lgbeno/BLDC-Booster/README.md

BLDC-Booster
============

BLDC Motor Control written for MSP430 Value Line processors
