lgbeno/BLDC-Booster/DOC/Scope Trace/adc_sampling-uart.pdf

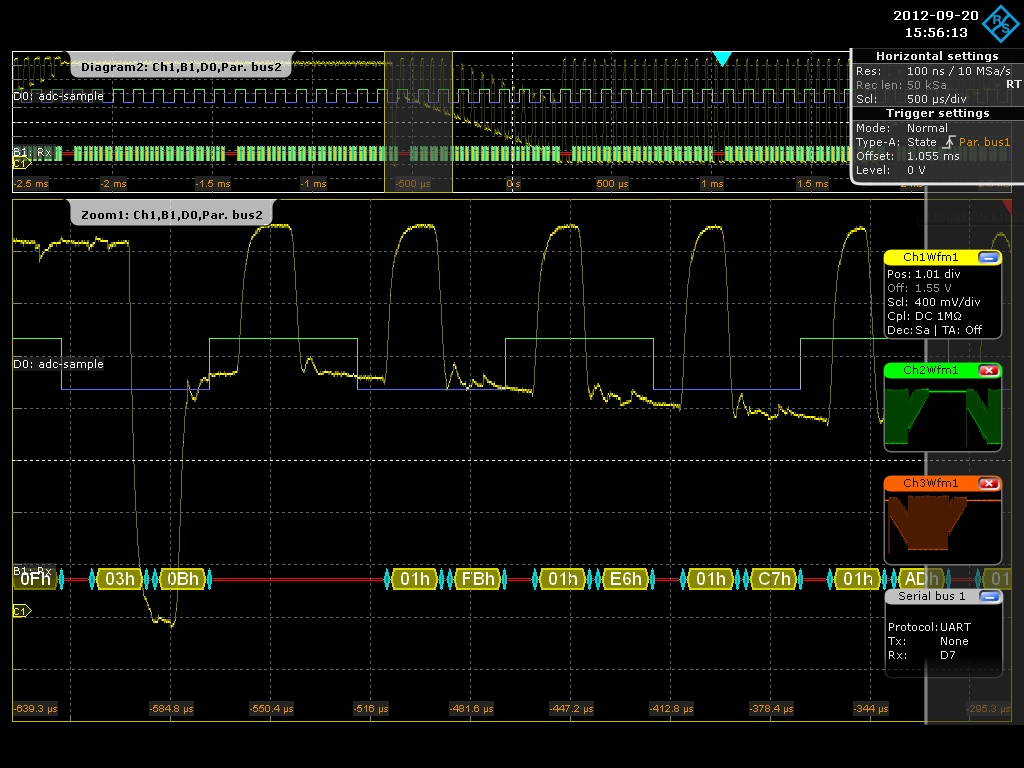
[picture p1: page 1]
