lgbeno/BLDC-Booster/DOC/Scope Trace/commutate-integral-2.pdf

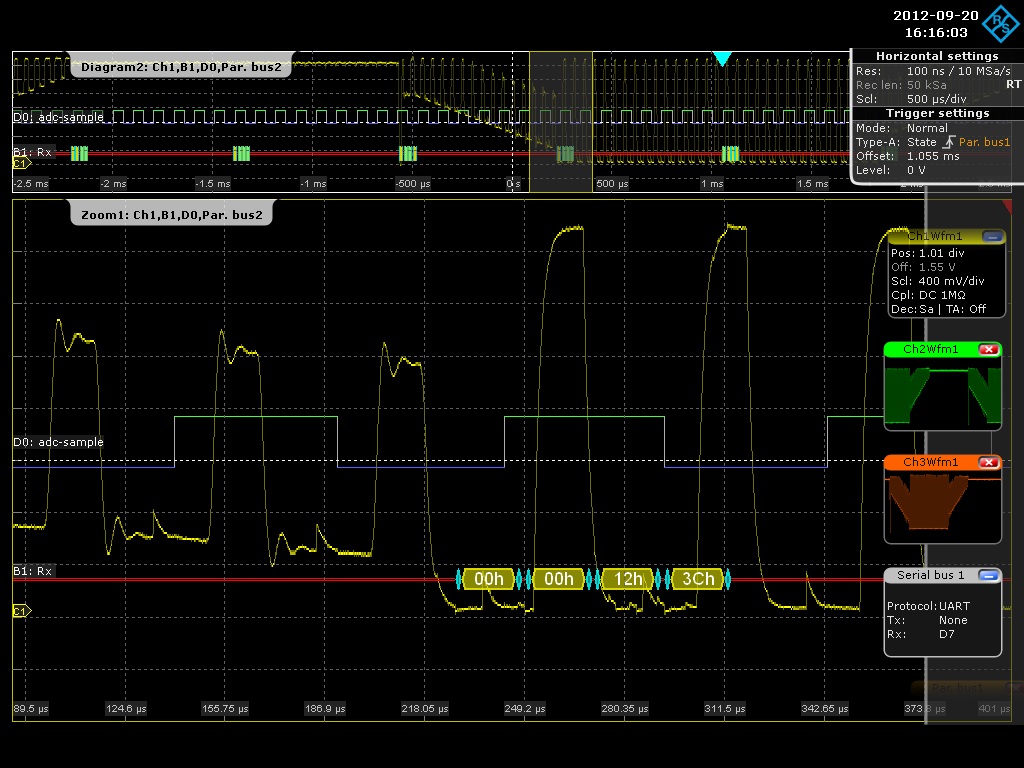
[picture p2: page 1]
