lgbeno/BLDC-Booster/DOC/Scope Trace/commutate-integral.pdf

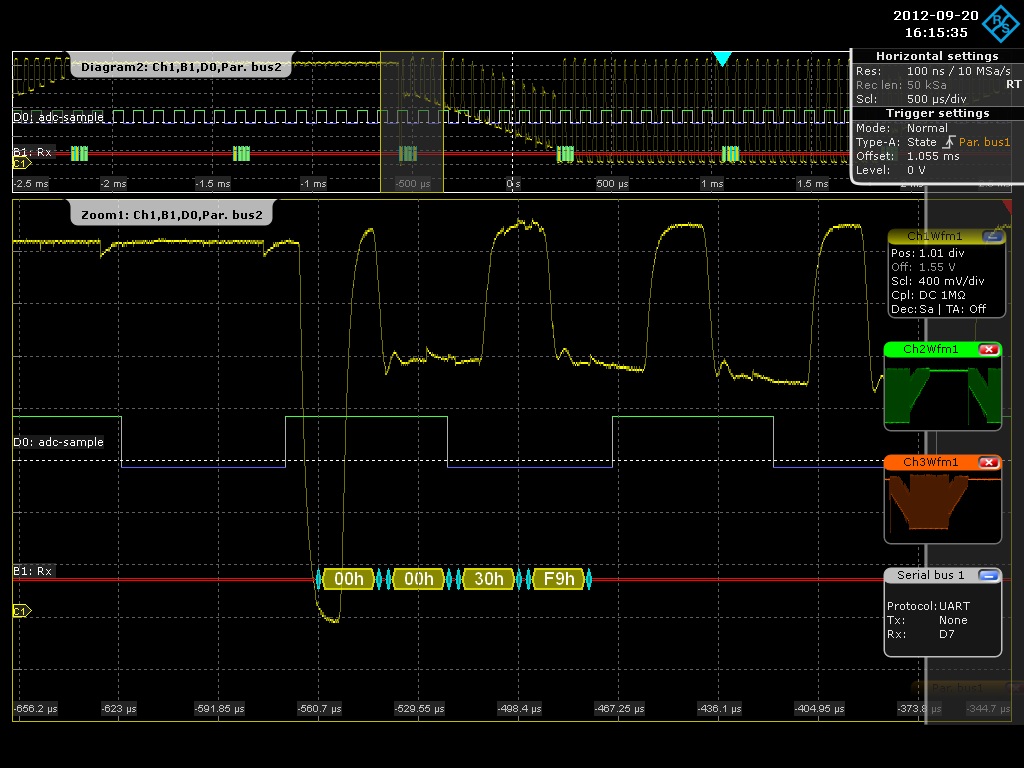
[picture p3: page 1]
