lgbeno/BLDC-Booster/DOC/Scope Trace/fullview.pdf

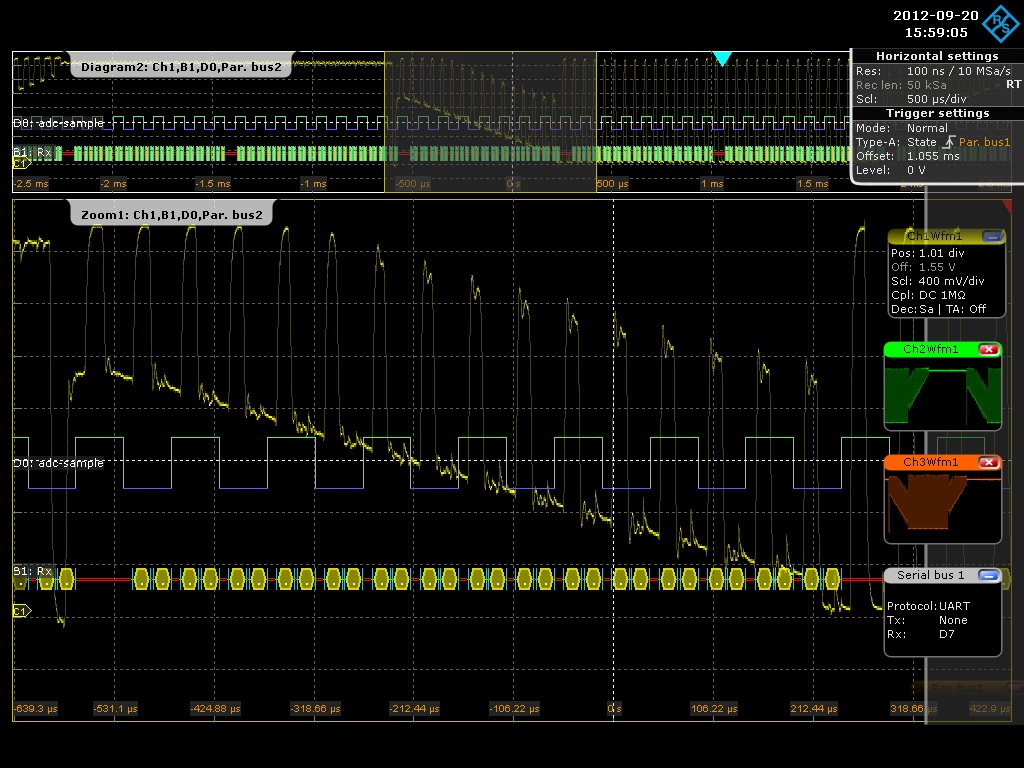
[picture p4: page 1]
