lgbeno/BLDC-Booster/DOC/Scope Trace/more-samples.pdf

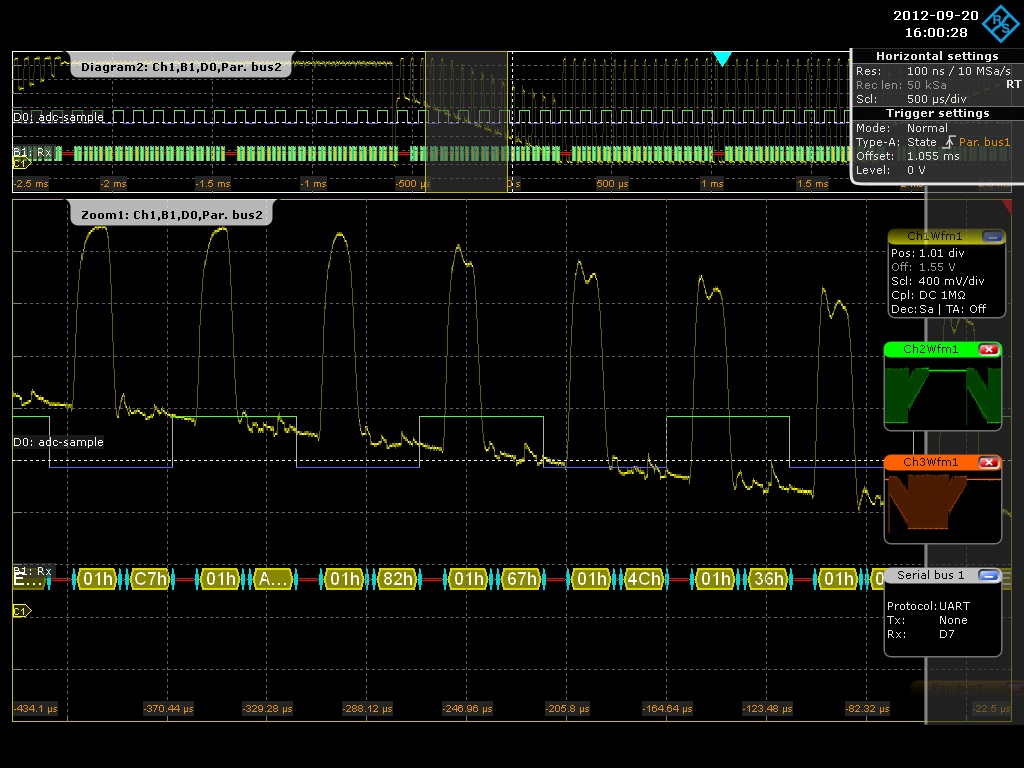
[picture p5: page 1]
