lgbeno/BLDC-Booster/DOC/integral.png

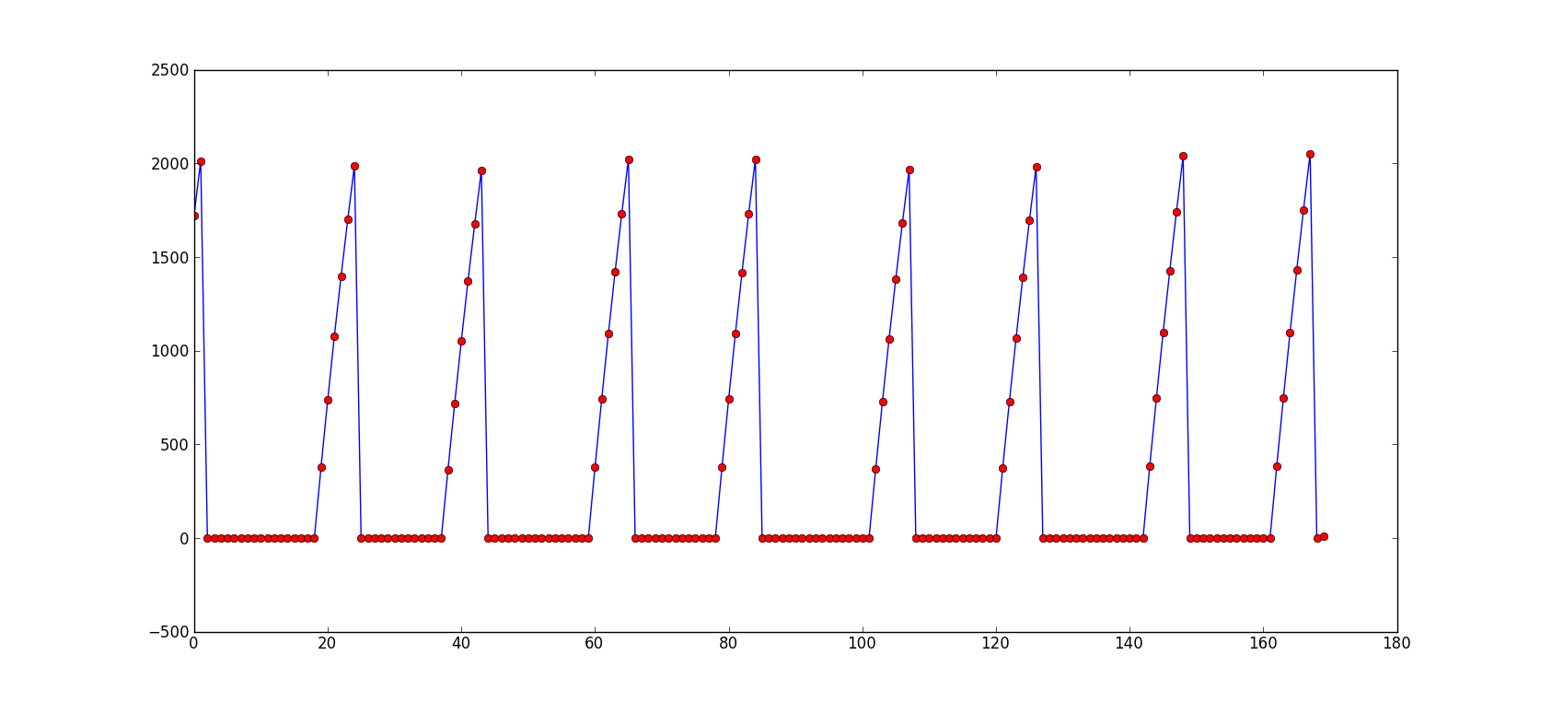
DOC/integral.png
