lgbeno/BLDC-Booster/DOC/muxed+vpwr.png

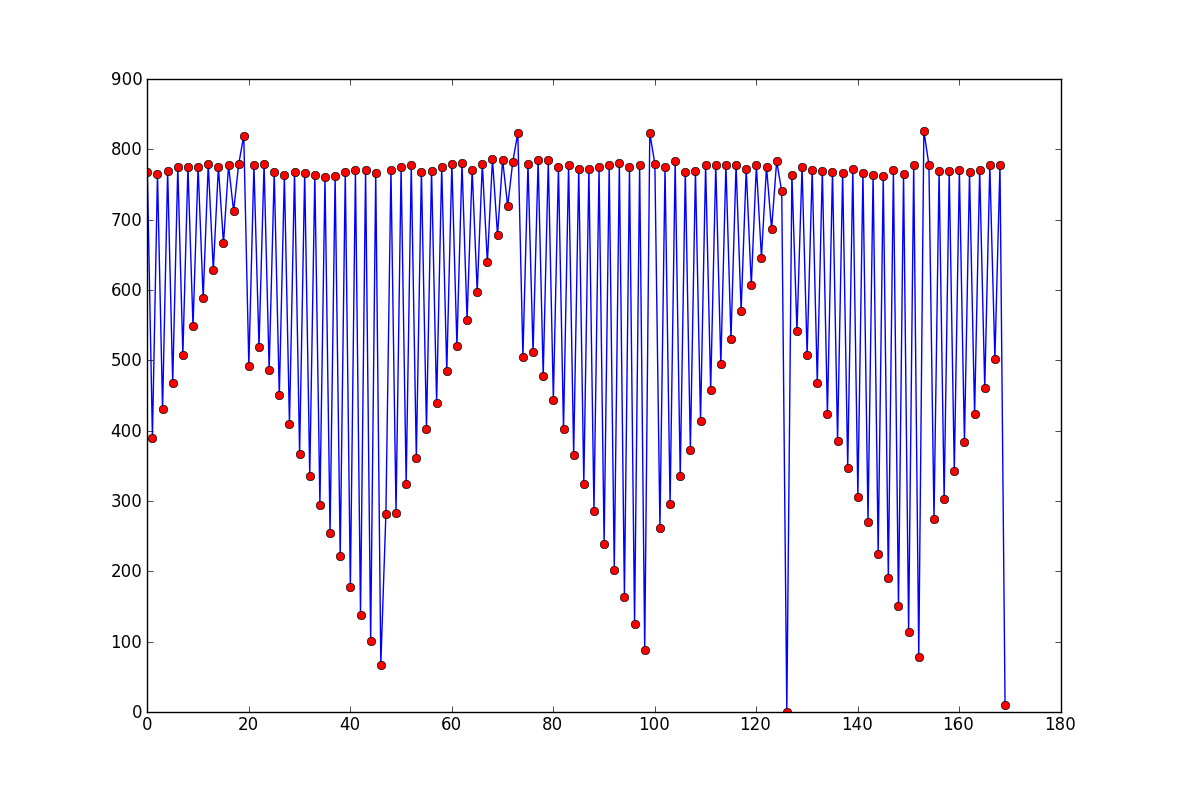
DOC/muxed+vpwr.png
