lgbeno/BLDC-Booster/DOC/Scope Trace/mtr-v2.png

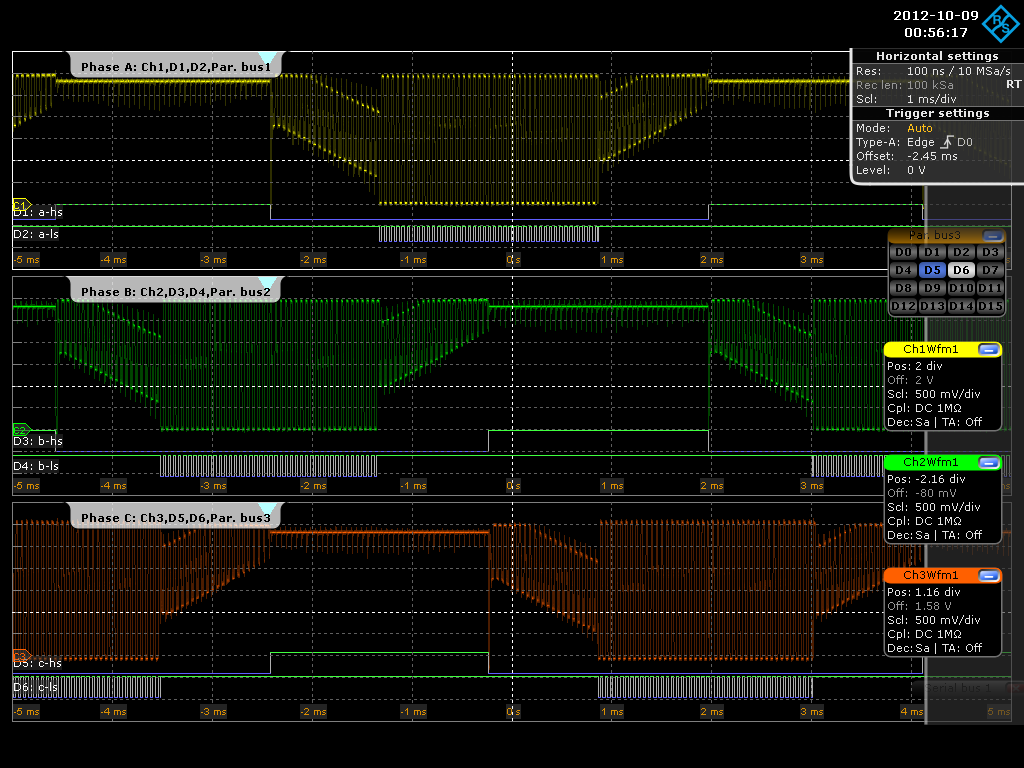
DOC/Scope Trace/mtr-v2.png
