lgbeno/BLDC-Booster/DOC/Scope Trace/mtr-v.png

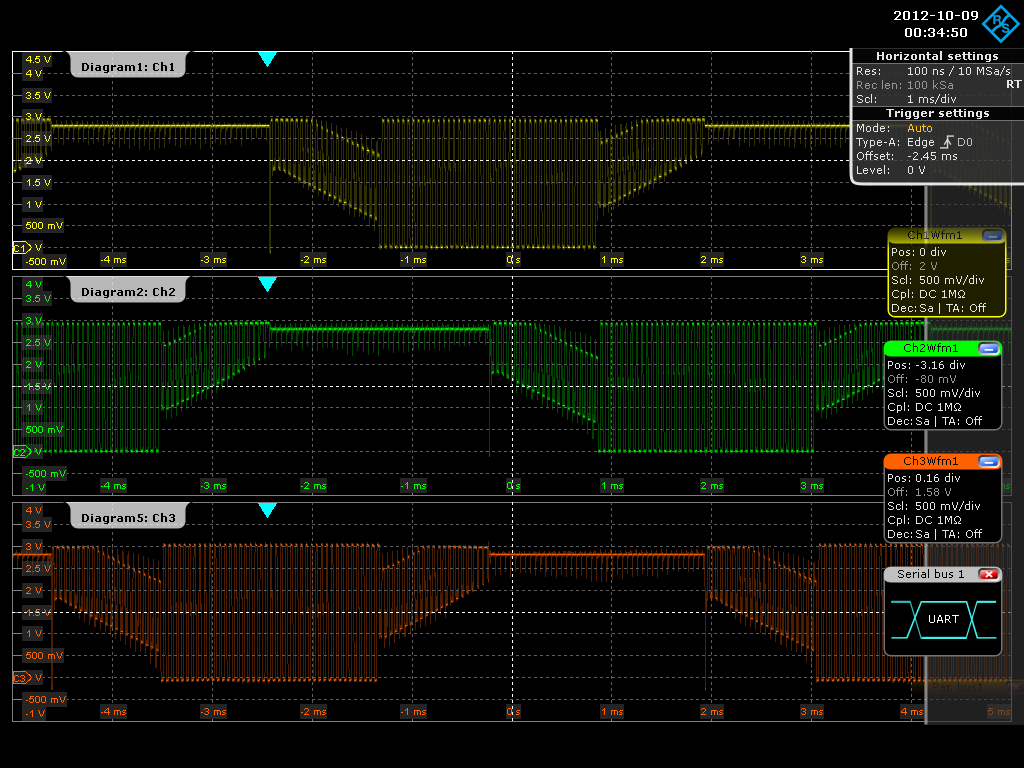
DOC/Scope Trace/mtr-v.png
