lgbeno/BLDC-Booster/DOC/single_phase+vpwr.png

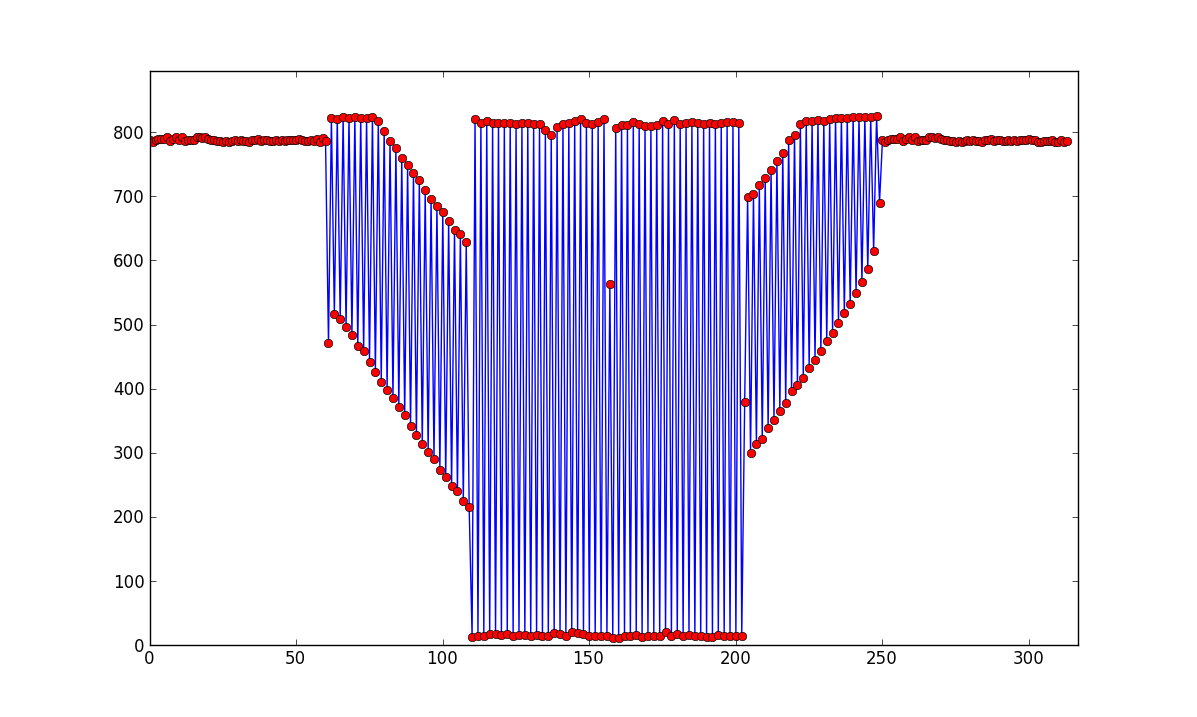
DOC/single_phase+vpwr.png
