lgbeno/BLDC-Booster/python/datasets/blanking-data/benf.png

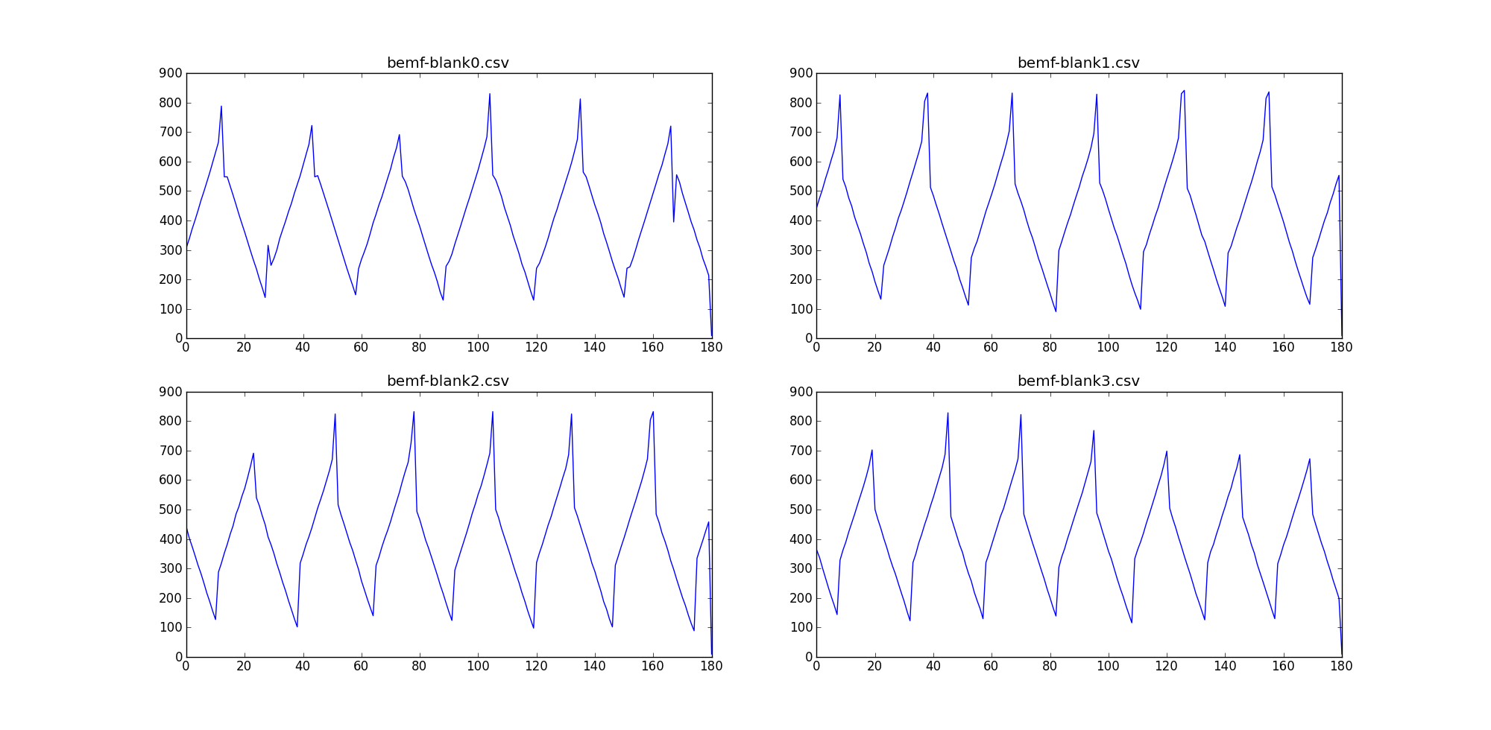
python/datasets/blanking-data/benf.png
