lgbeno/BLDC-Booster/python/datasets/blanking-data/integral.png

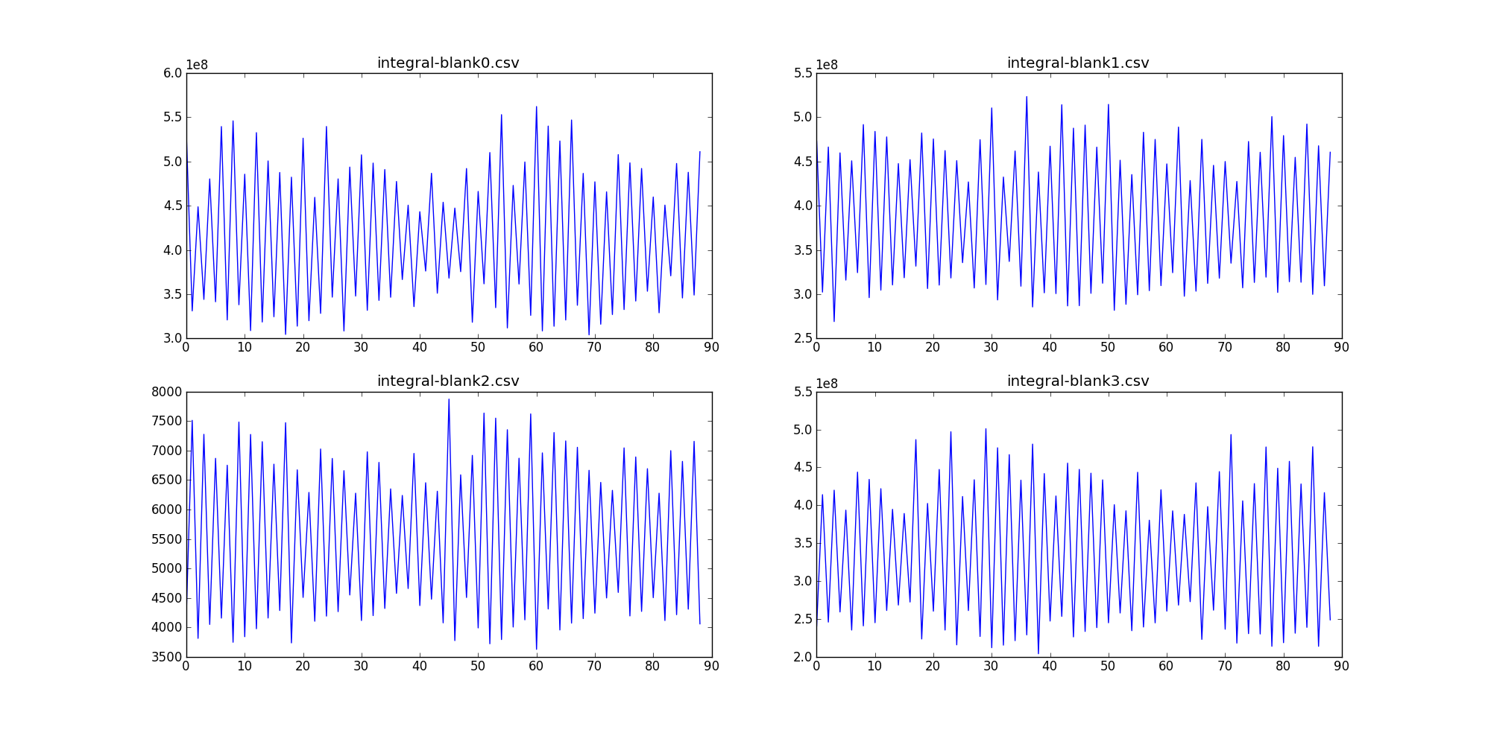
python/datasets/blanking-data/integral.png
