lgbeno/BLDC-Booster/python/datasets/blanking-data/integralh.png

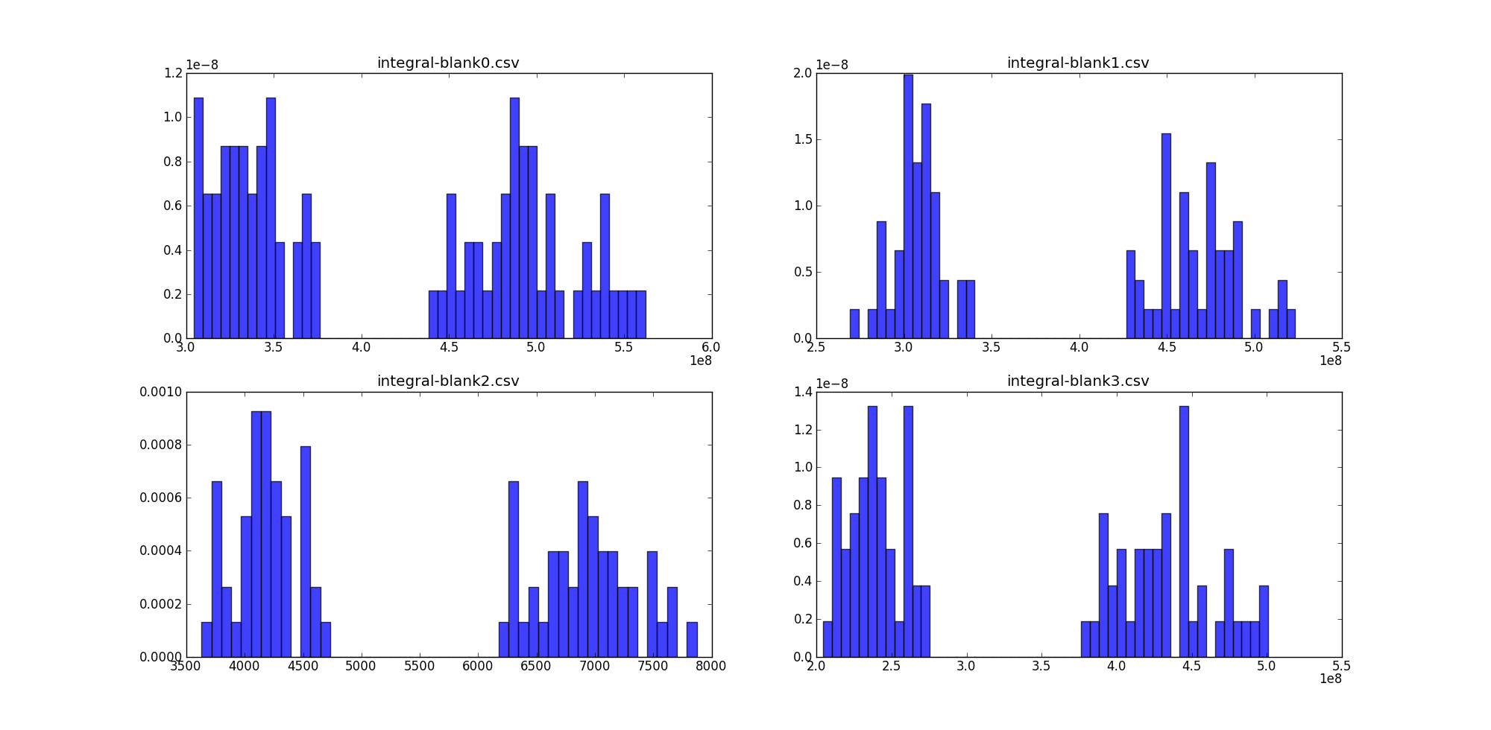
python/datasets/blanking-data/integralh.png
