lgbeno/BLDC-Booster/python/datasets/blanking-data/pha.png

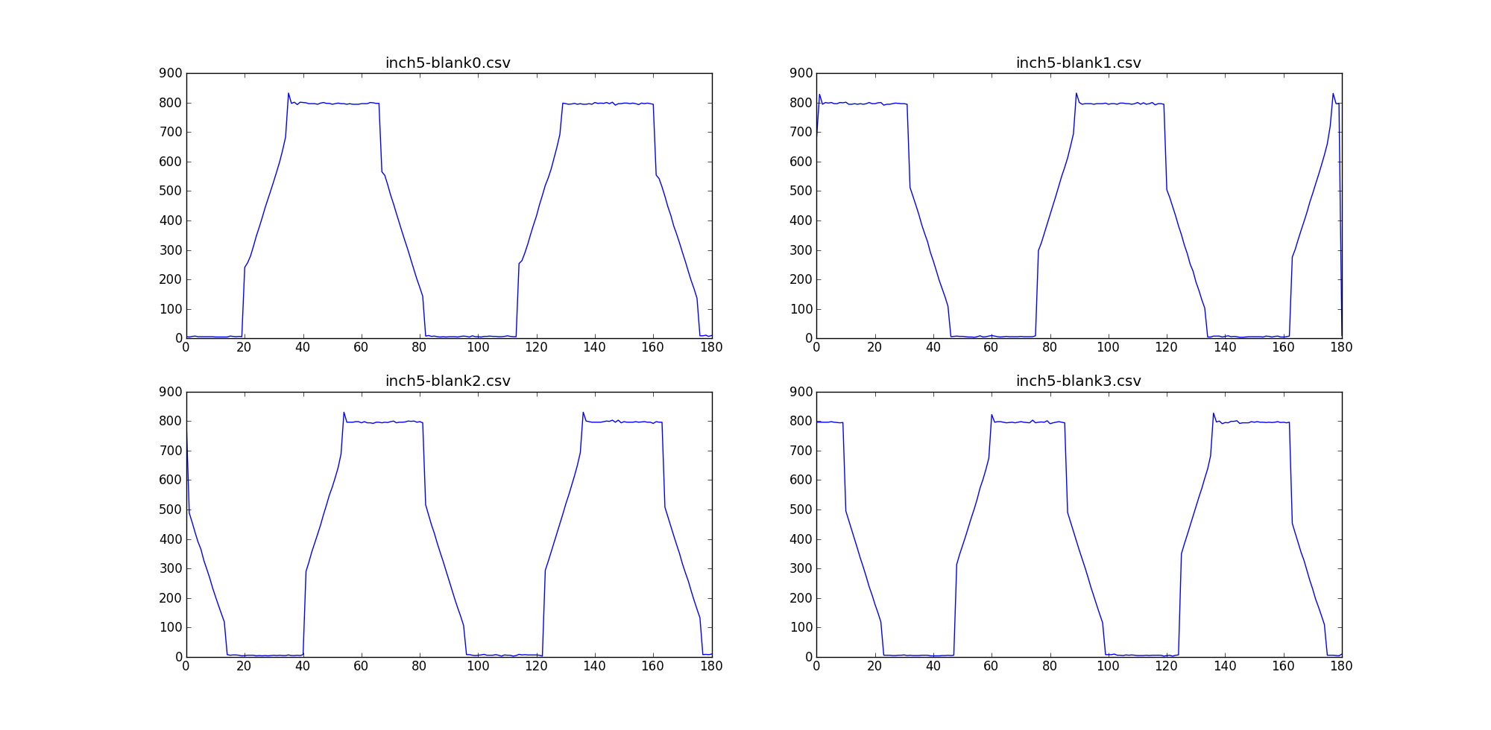
python/datasets/blanking-data/pha.png
