lgbeno/BLDC-Booster/python/datasets/run-data/BEMFblank0.png

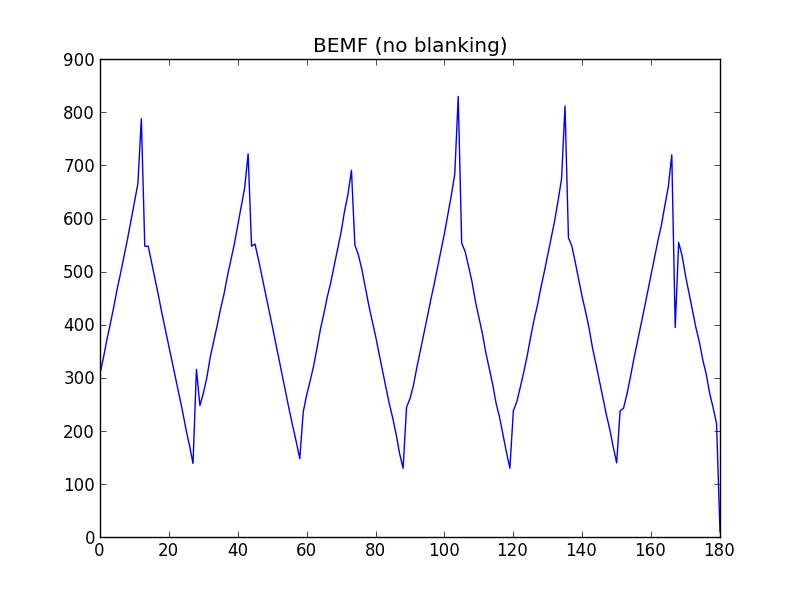
python/datasets/run-data/BEMFblank0.png
