lgbeno/BLDC-Booster/python/datasets/run-data/BEMFblank1.png

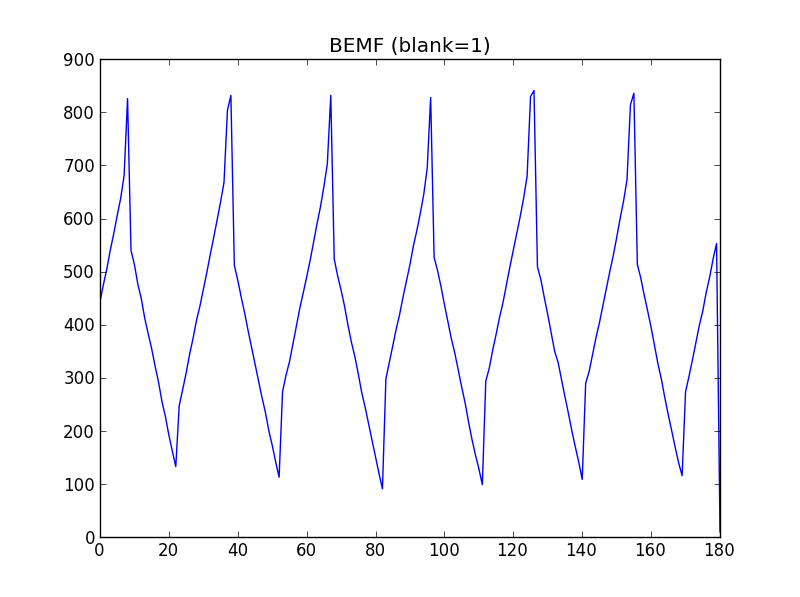
python/datasets/run-data/BEMFblank1.png
