lgbeno/BLDC-Booster/python/datasets/run-data/BEMFblank2.png

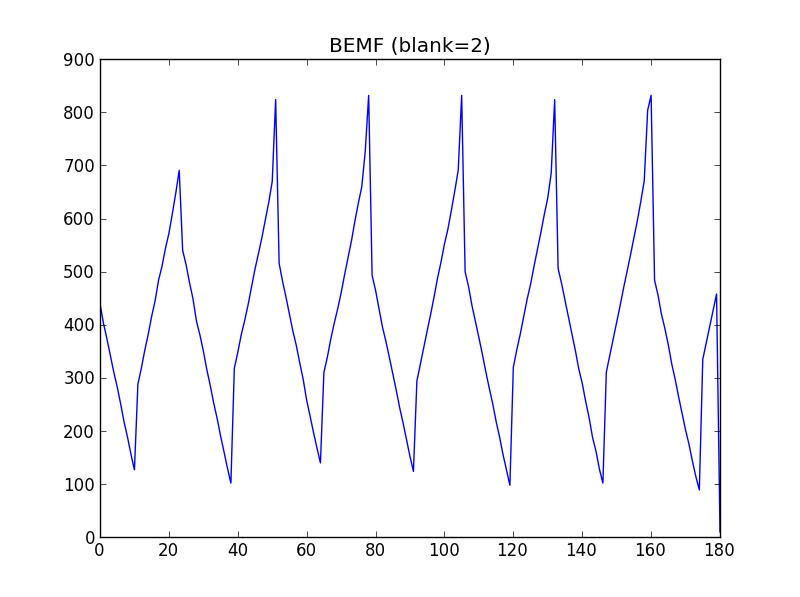
python/datasets/run-data/BEMFblank2.png
