lgbeno/BLDC-Booster/python/datasets/run-data/intpltblank0.png

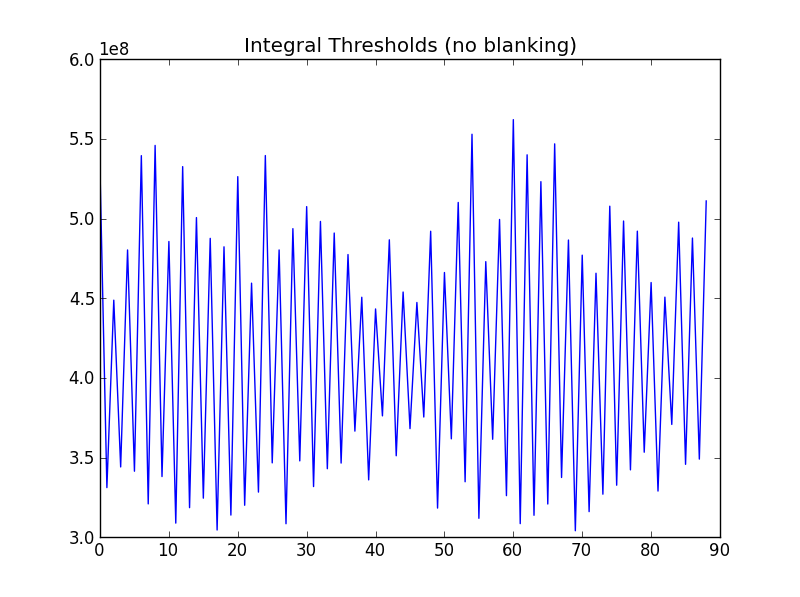
python/datasets/run-data/intpltblank0.png
