lgbeno/BLDC-Booster/python/datasets/run-data/intpltblank1.png

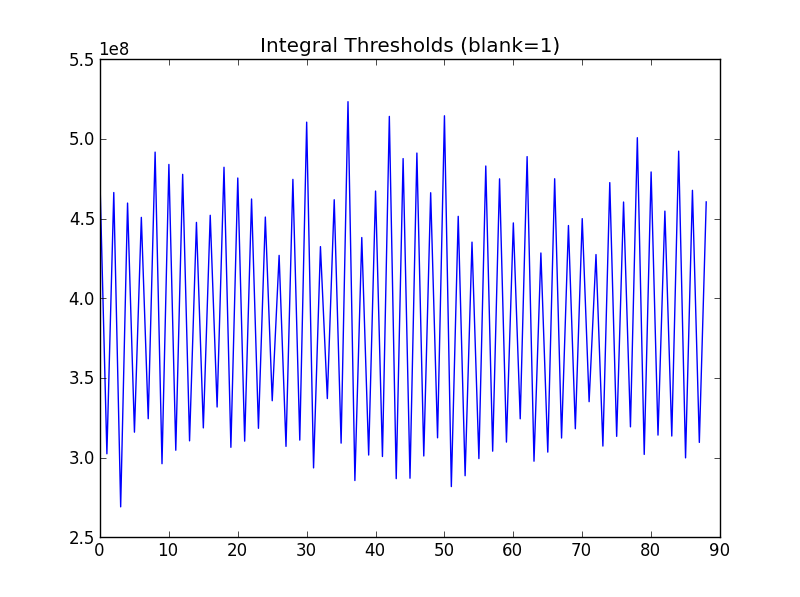
python/datasets/run-data/intpltblank1.png
