lgbeno/BLDC-Booster/python/datasets/run-data/intpltblank2.png

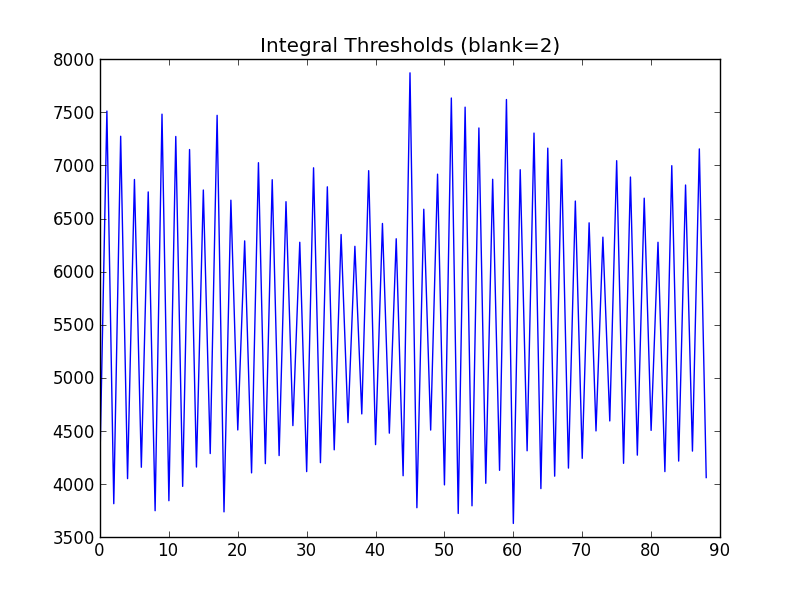
python/datasets/run-data/intpltblank2.png
