lgbeno/BLDC-Booster/python/datasets/run-data/PhAblank0.png

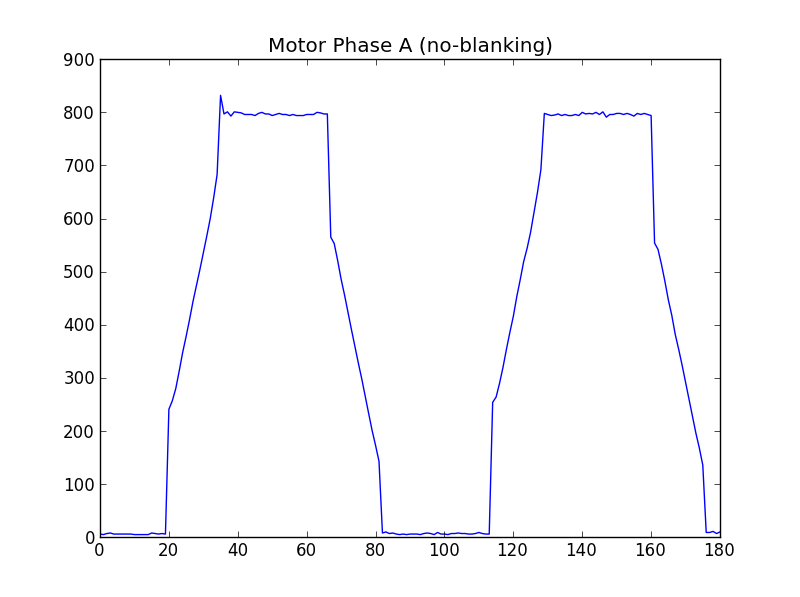
python/datasets/run-data/PhAblank0.png
