lgbeno/BLDC-Booster/python/datasets/run-data/PhAblank1.png

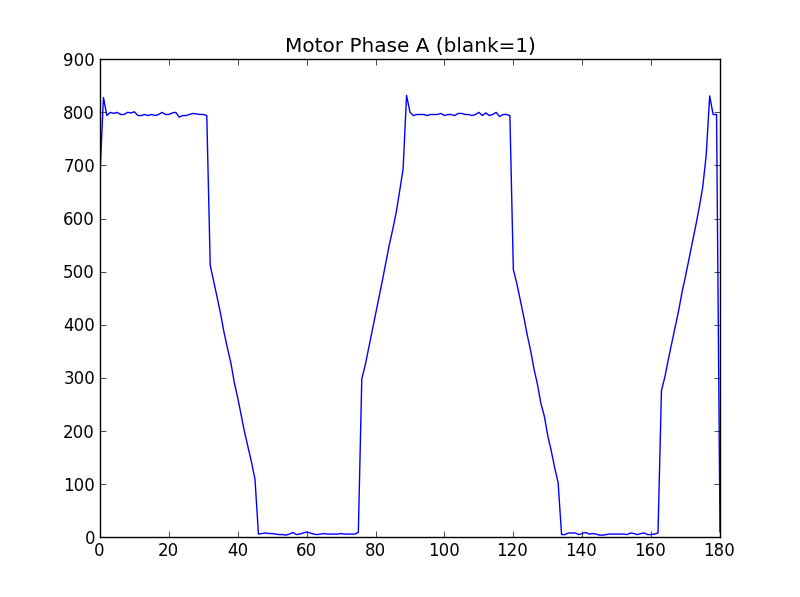
python/datasets/run-data/PhAblank1.png
