lgbeno/BLDC-Booster/python/datasets/run-data/PhAblank2.png

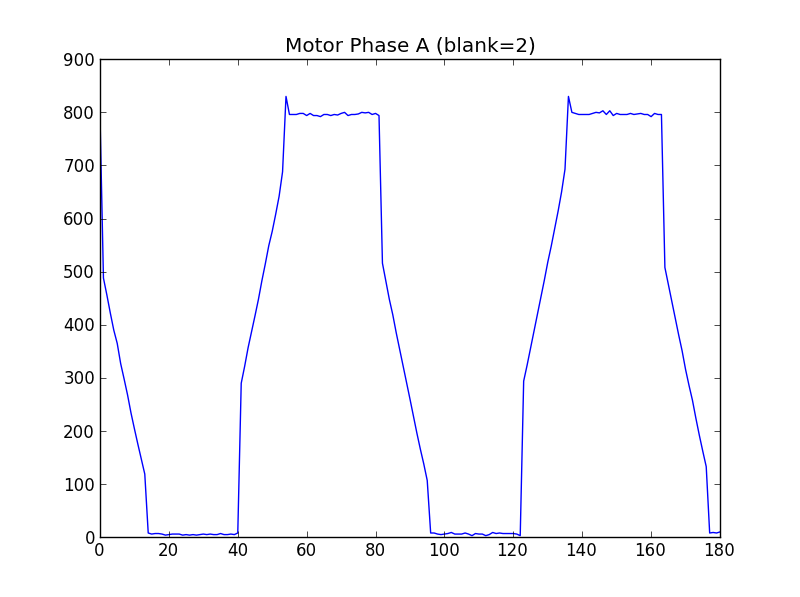
python/datasets/run-data/PhAblank2.png
