lgbeno/BLDC-Booster/python/pictures/bemf+center2.png

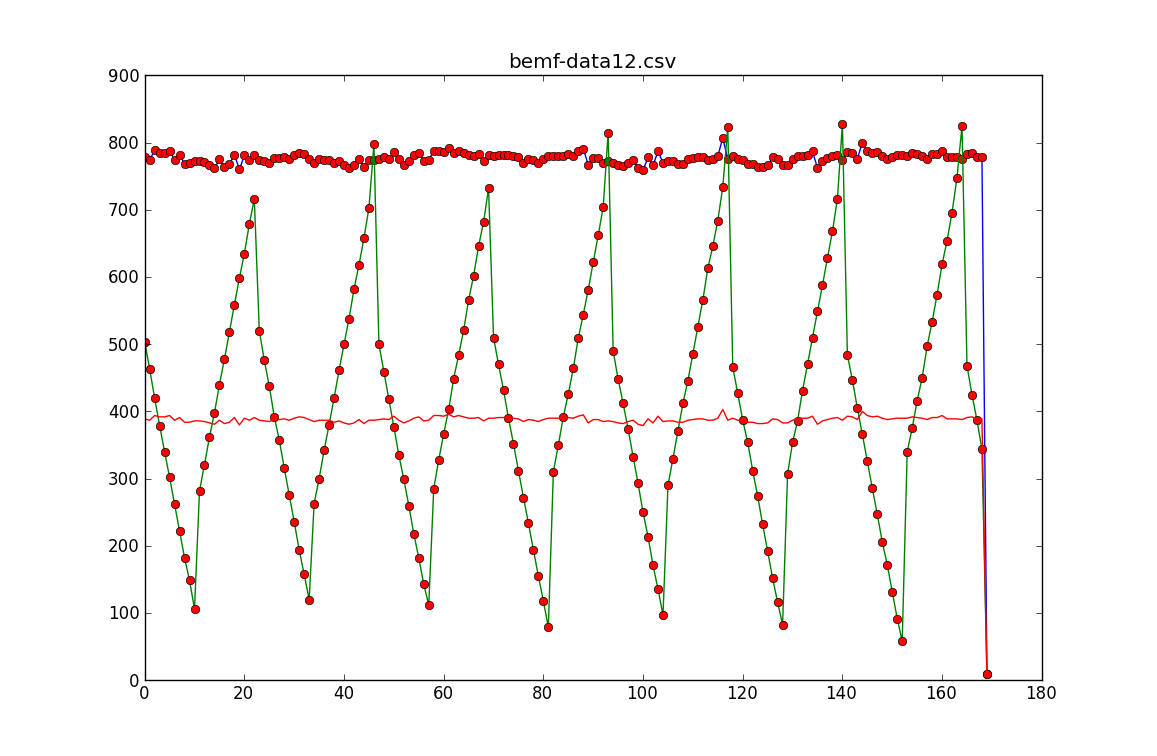
python/pictures/bemf+center2.png
