lgbeno/BLDC-Booster/python/pictures/bemf+center.png

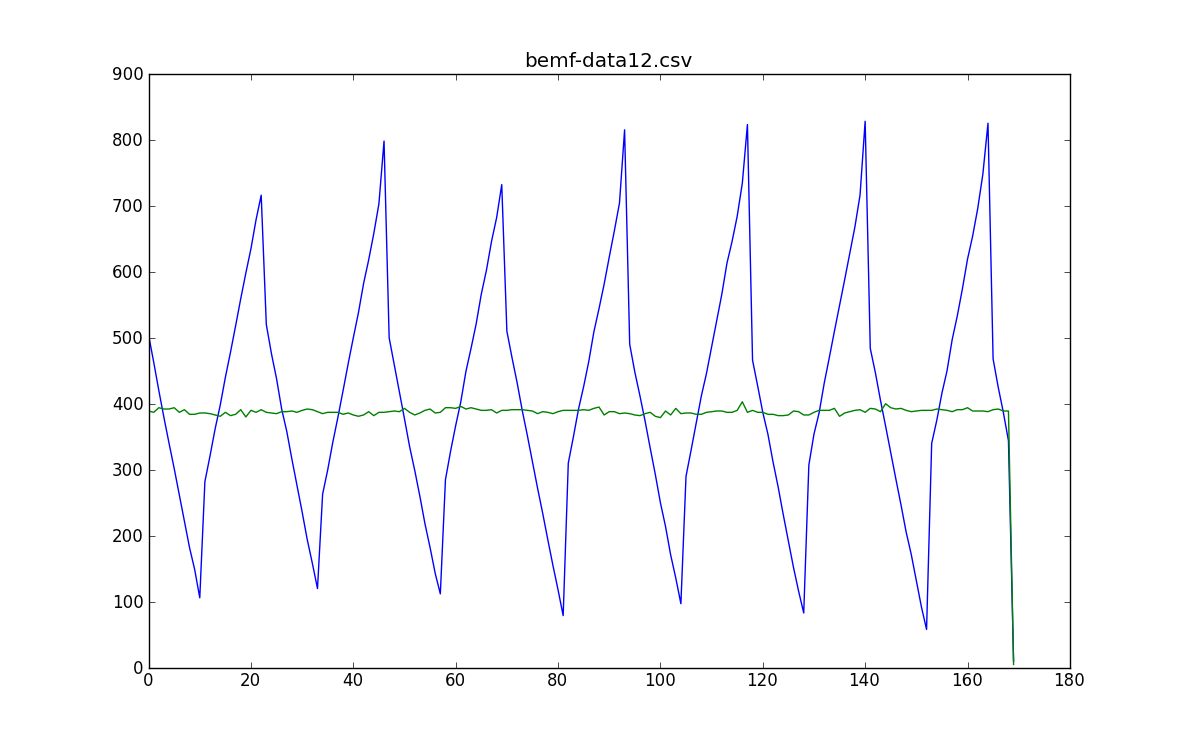
python/pictures/bemf+center.png
