lgbeno/BLDC-Booster/python/pictures/bemf+vpwr.png

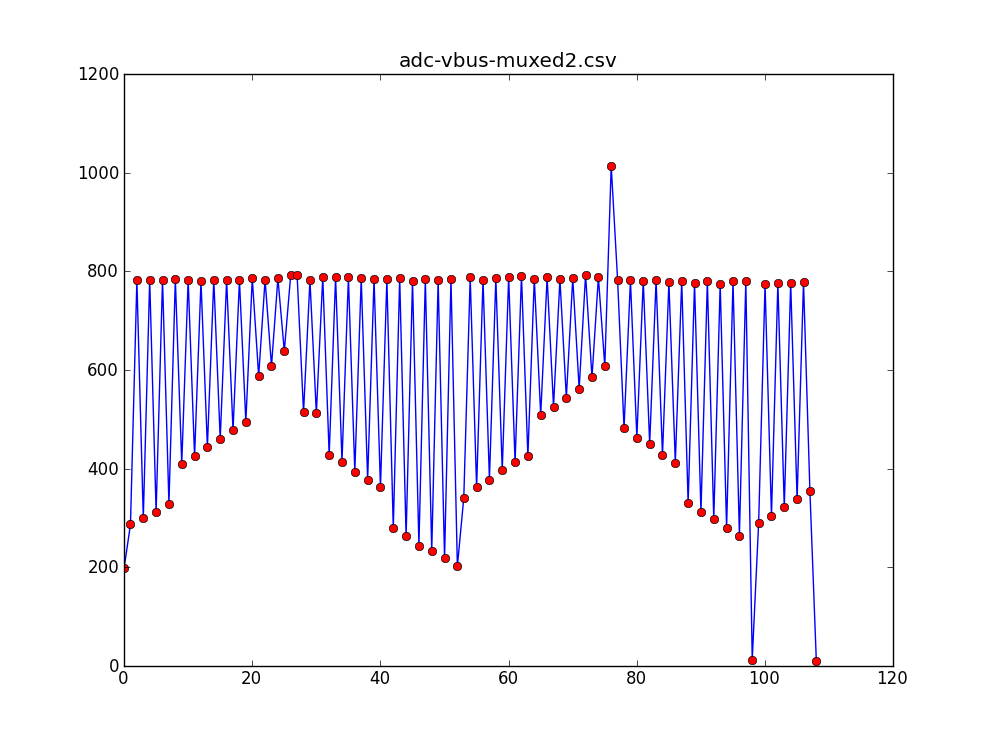
python/pictures/bemf+vpwr.png
