lgbeno/BLDC-Booster/python/pictures/bemf_corrected.png

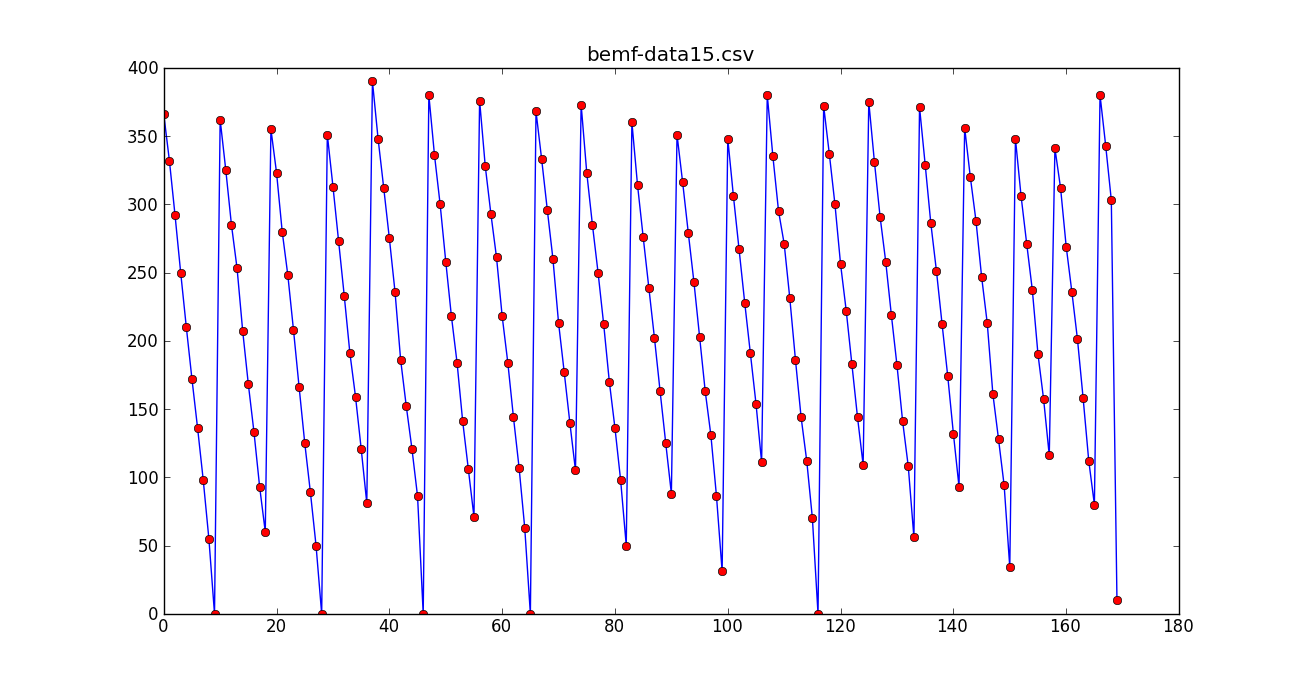
python/pictures/bemf_corrected.png
