lgbeno/BLDC-Booster/python/pictures/bemf_dots2.png

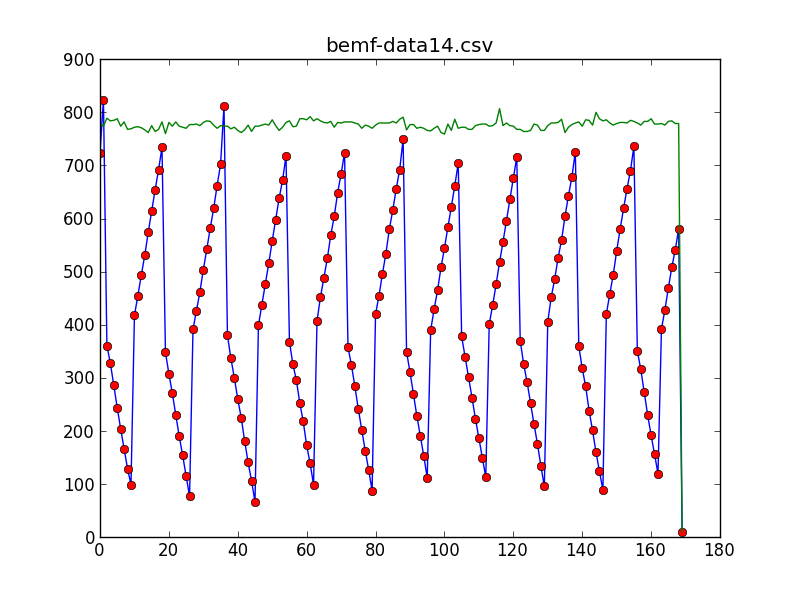
python/pictures/bemf_dots2.png
