lgbeno/BLDC-Booster/python/pictures/bemf_dots.png

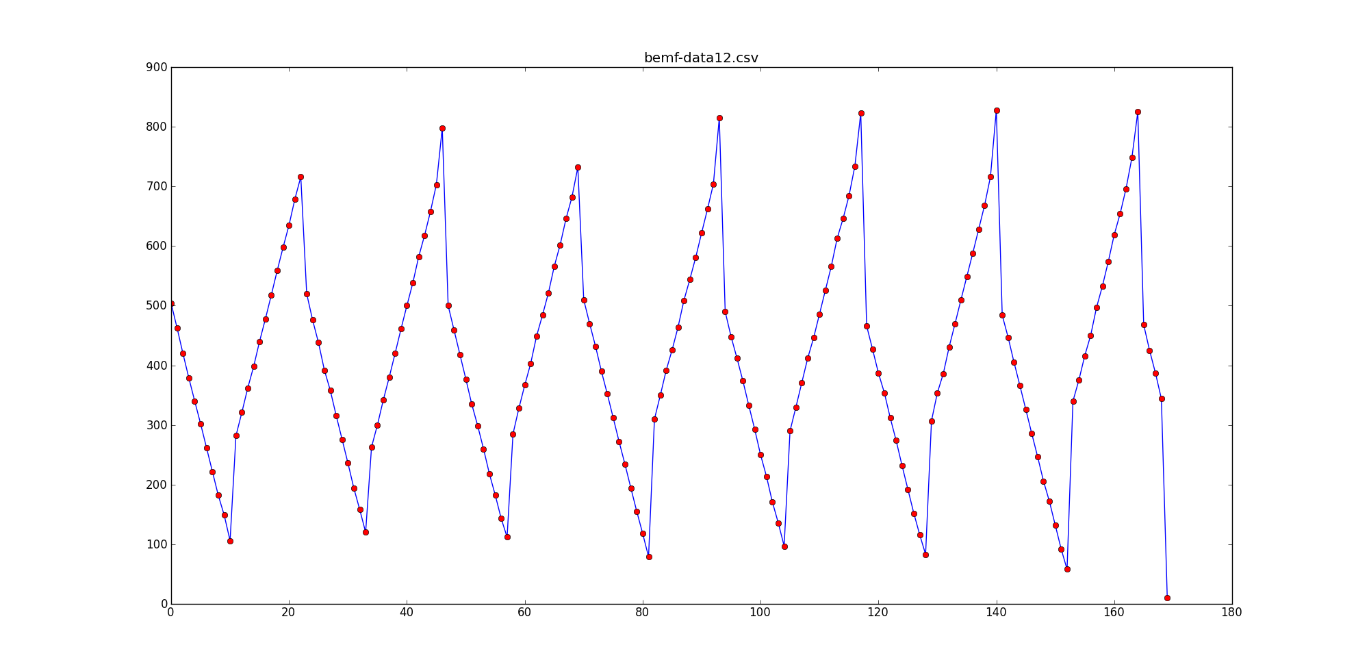
python/pictures/bemf_dots.png
