lgbeno/BLDC-Booster/python/pictures/integrals.png

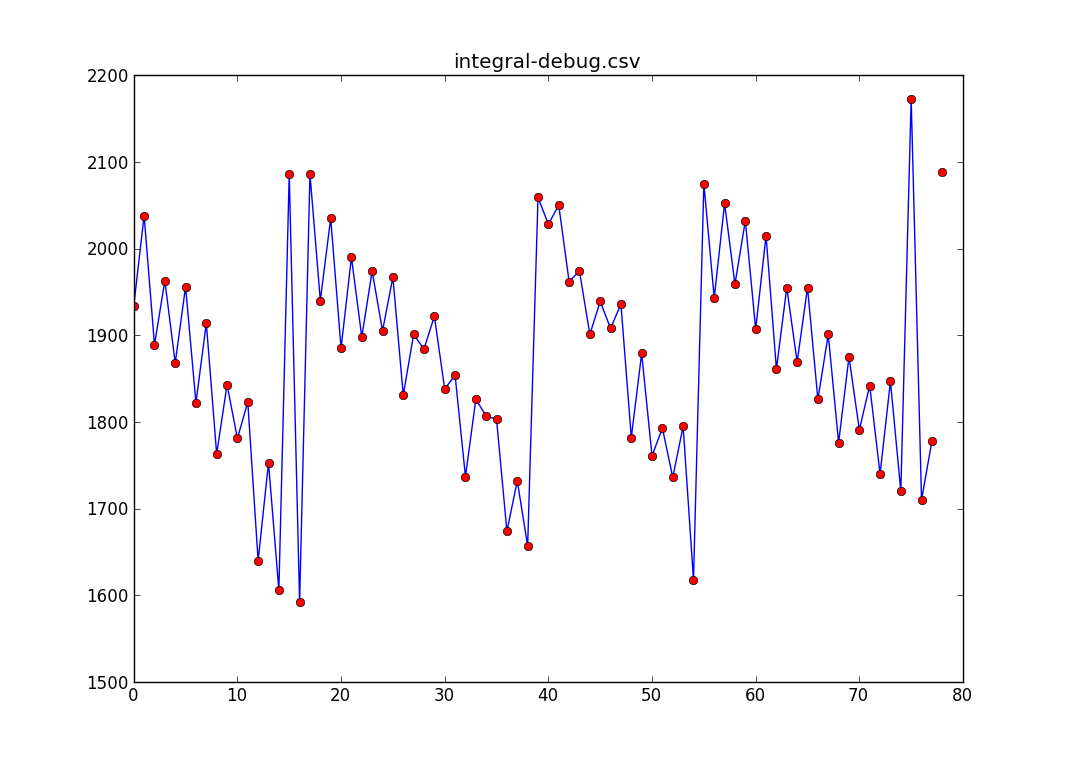
python/pictures/integrals.png
