lgbeno/BLDC-Booster/python/pictures/wave+vpwr.png

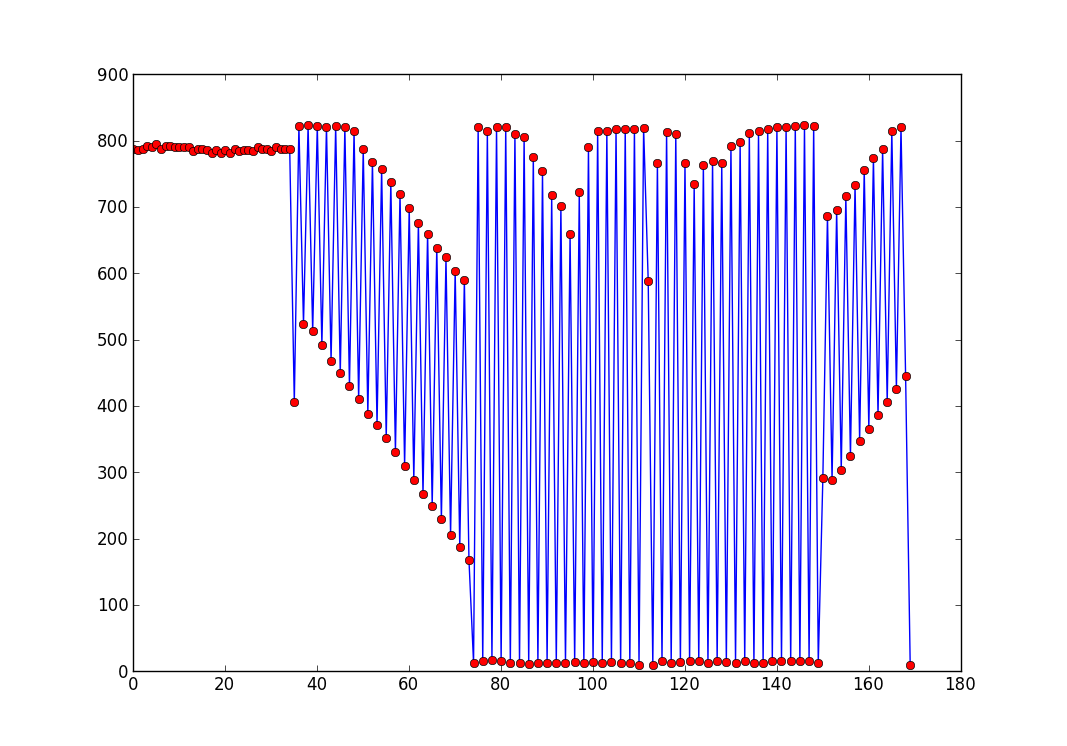
python/pictures/wave+vpwr.png
