lgbeno/BLDC-Booster/hw/logos/WI-Icon_sim.dxf

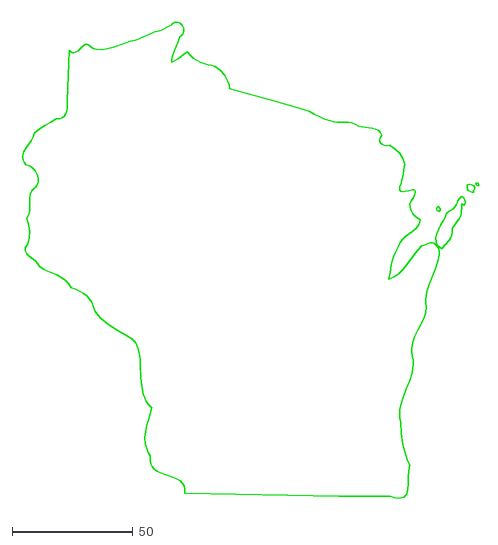
[picture p32: CAD file, 2012-09-01]
hw/logos/WI-Icon_sim.dxf
192.8 x 202.5
