lgbeno/BLDC-Booster/hw/logos/wi_bottom.dxf

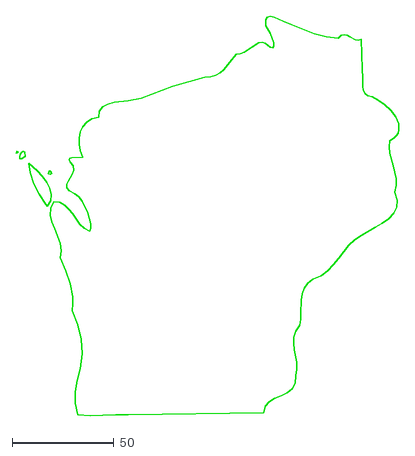
[picture p33: CAD file, 2012-09-01]
hw/logos/wi_bottom.dxf
188.3 x 196.2
