lgbeno/BLDC-Booster/hw/logos/wi.dxf

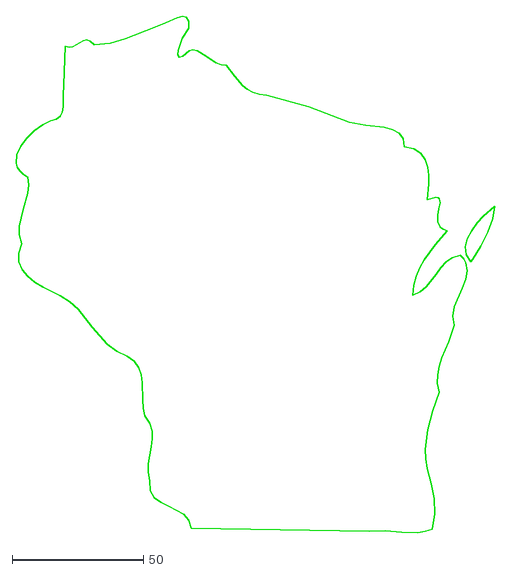
[picture p34: CAD file, 2012-09-01]
hw/logos/wi.dxf
182.1 x 196.3
