lgbeno/BLDC-Booster/hw/logos/oshw.dxf

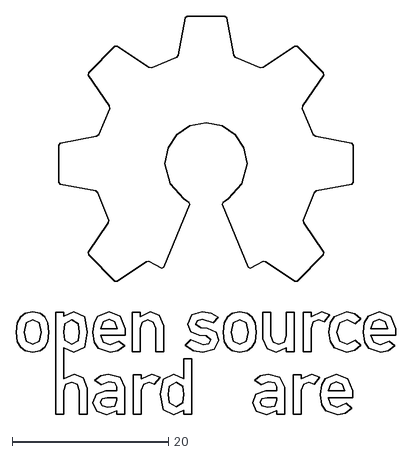
[picture p35: CAD file, 2012-09-01]
hw/logos/oshw.dxf
48.6 x 51.1
