lgbeno/BLDC-Booster/(list of files, cad)

Other CAD files:
firmware/ccs/Launchpad/Debug/src/hall.obj
firmware/ccs/Launchpad/Debug/tinyclib/printf.obj
firmware/ccs/Launchpad/Debug/src/pwm.obj
firmware/ccs/Launchpad/Debug/tinyclib/putchar.obj
firmware/ccs/Launchpad/Debug/src/commutate.obj
firmware/ccs/Launchpad/Debug/tinyclib/gets.obj
firmware/ccs/Launchpad/Debug/src/timer.obj
firmware/ccs/Launchpad/Debug/tinyclib/puts.obj
firmware/ccs/Launchpad/Debug/src/serial.obj
firmware/ccs/Launchpad/Debug/tinyclib/getchar.obj
