lgbeno/BLDC-Booster/hw/bldc_booster_pro - Schematic.pdf

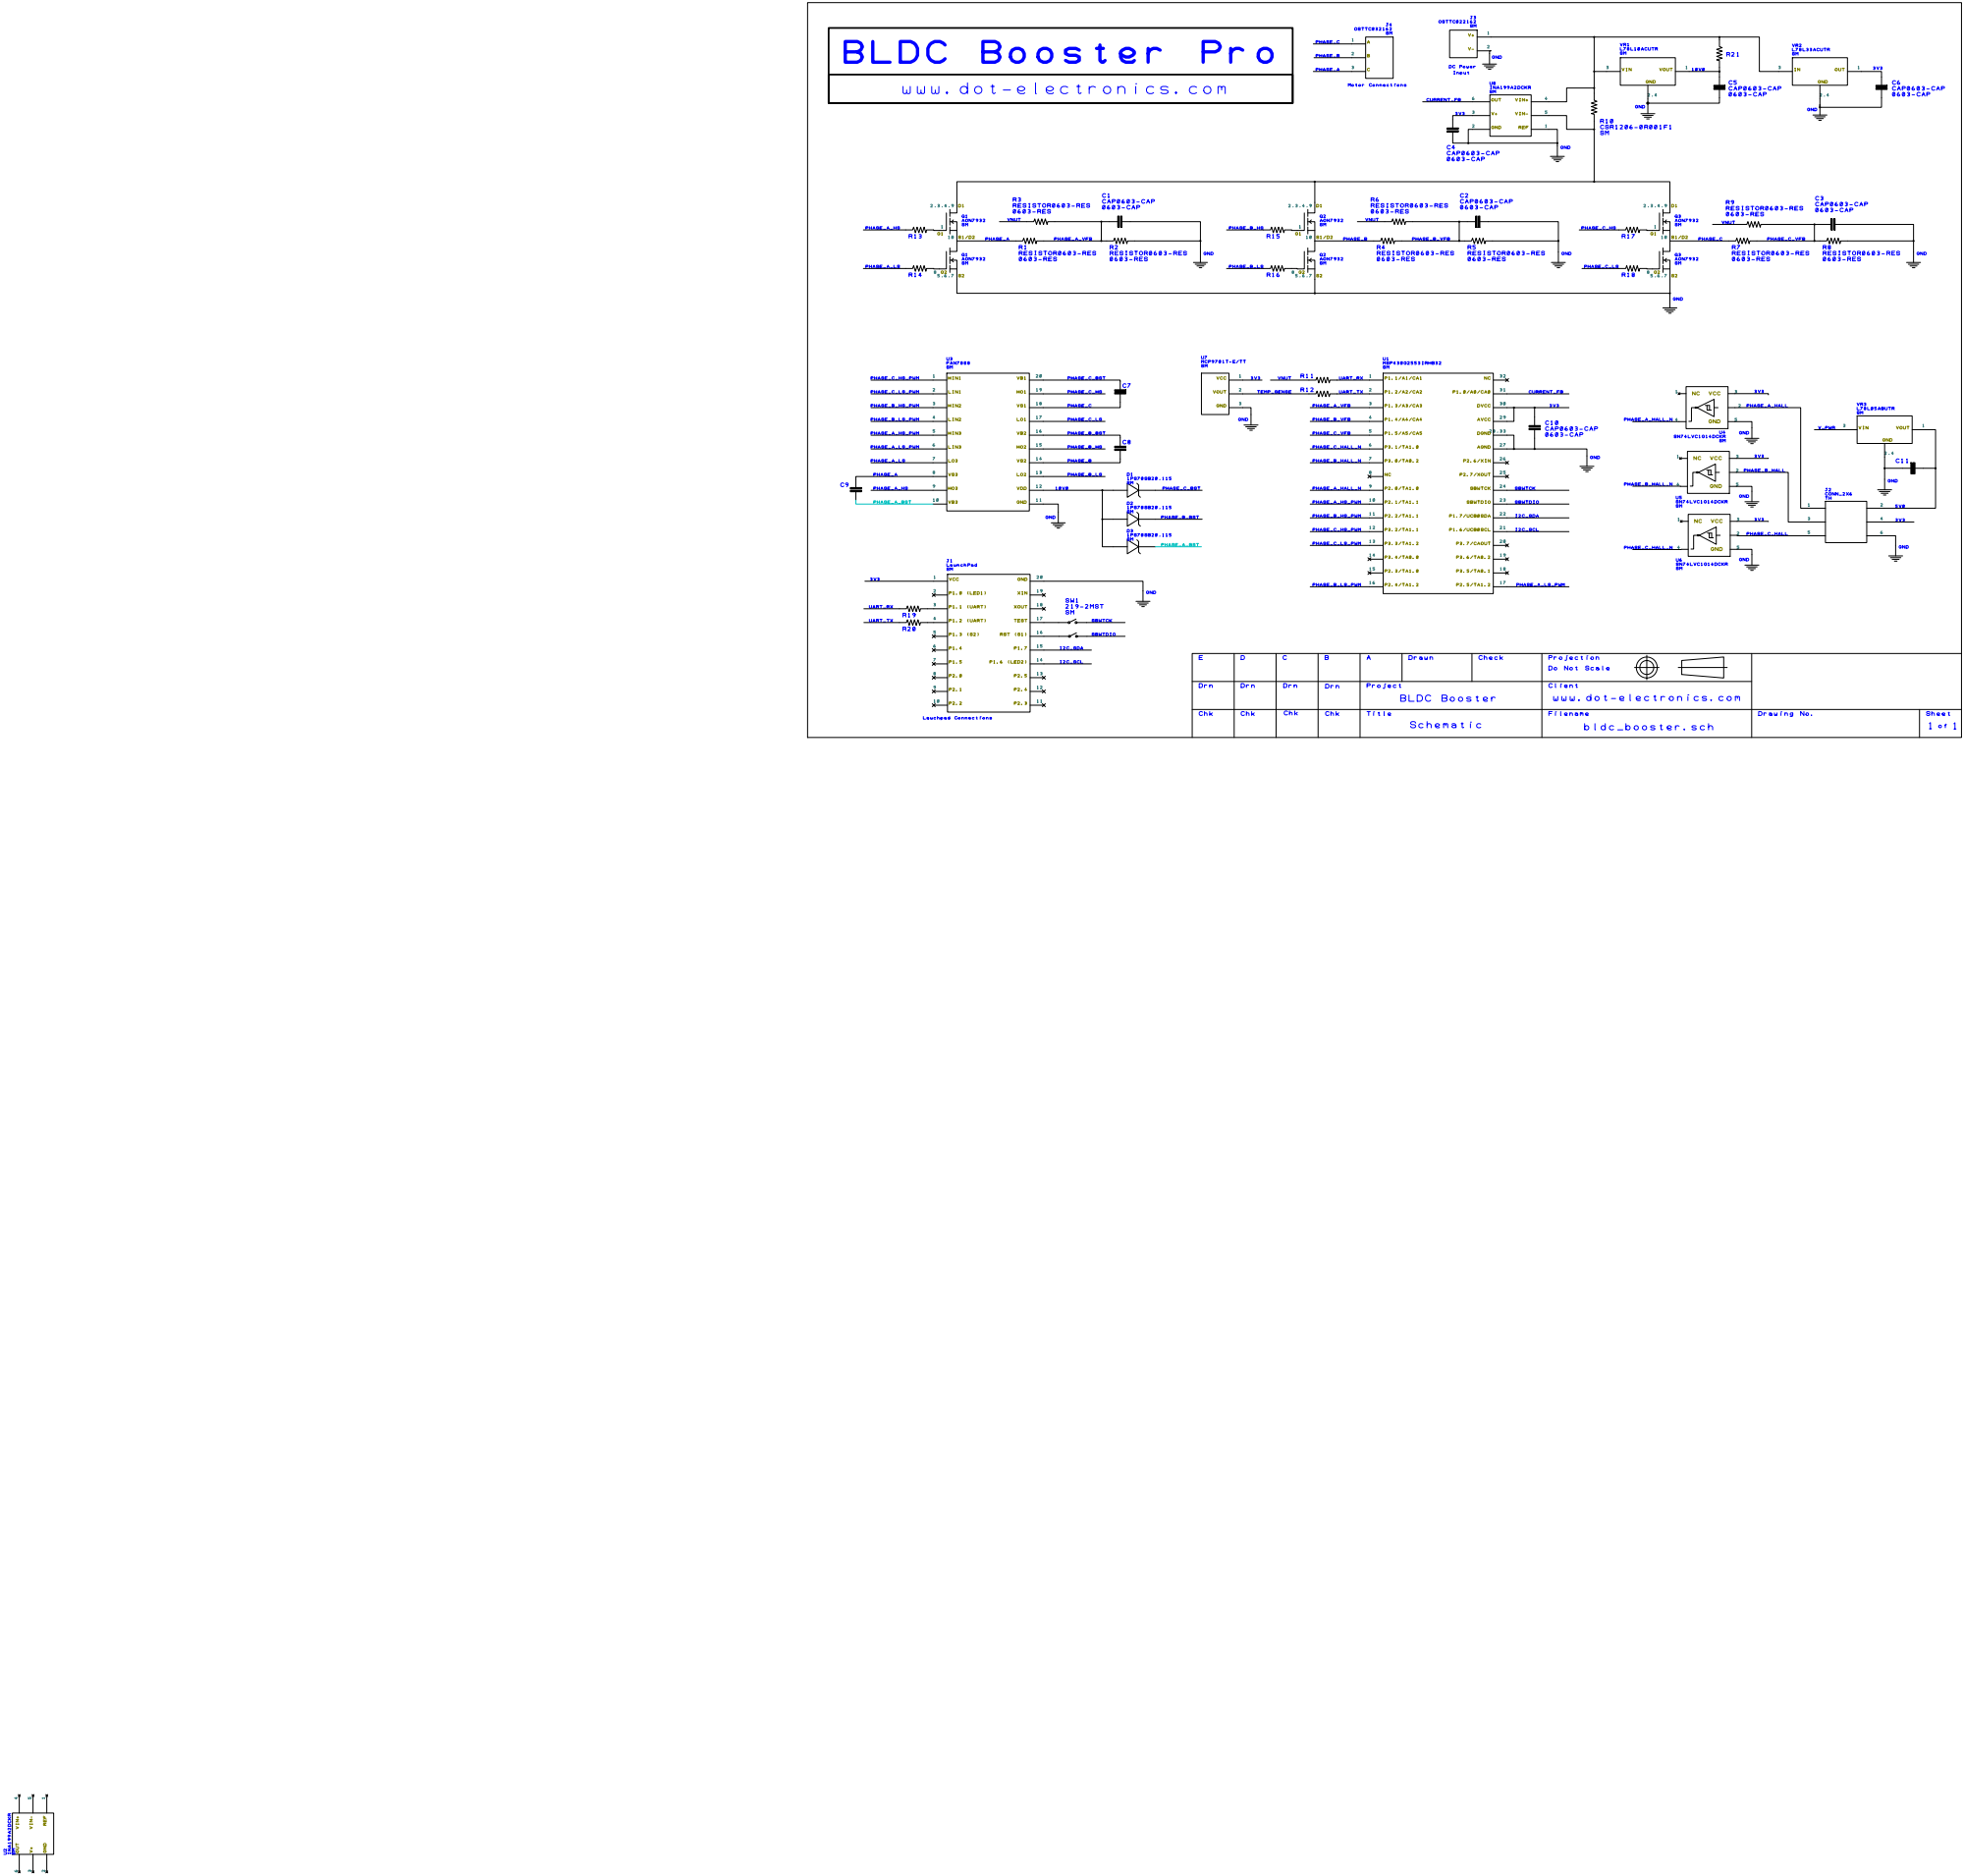
[picture p43: page 1]
