lgbeno/BLDC-Booster/hw/pdf/bldc_booster_asm_BOTTOM.PDF

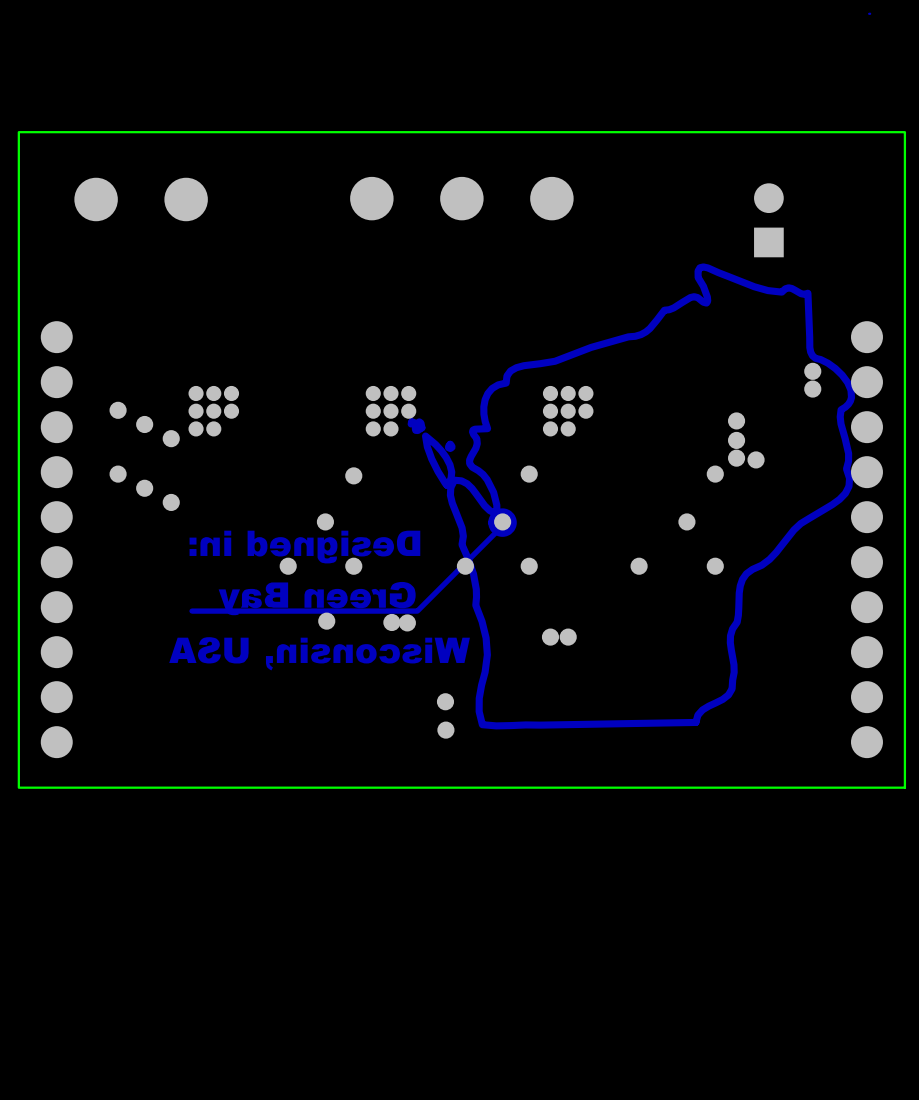
[picture p44: page 1]
