lgbeno/BLDC-Booster/hw/pdf/bldc_booster_asm_bottom_dwg.pdf

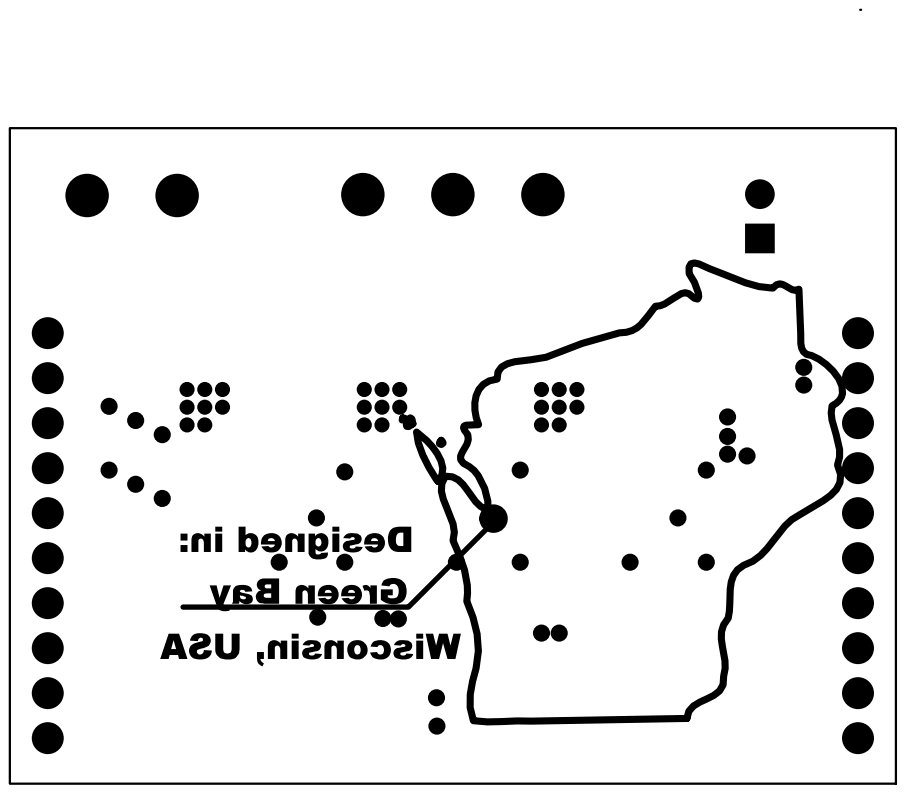
[picture p45: page 1]
