lgbeno/BLDC-Booster/hw/pdf/bldc_booster_asm_top.PDF

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

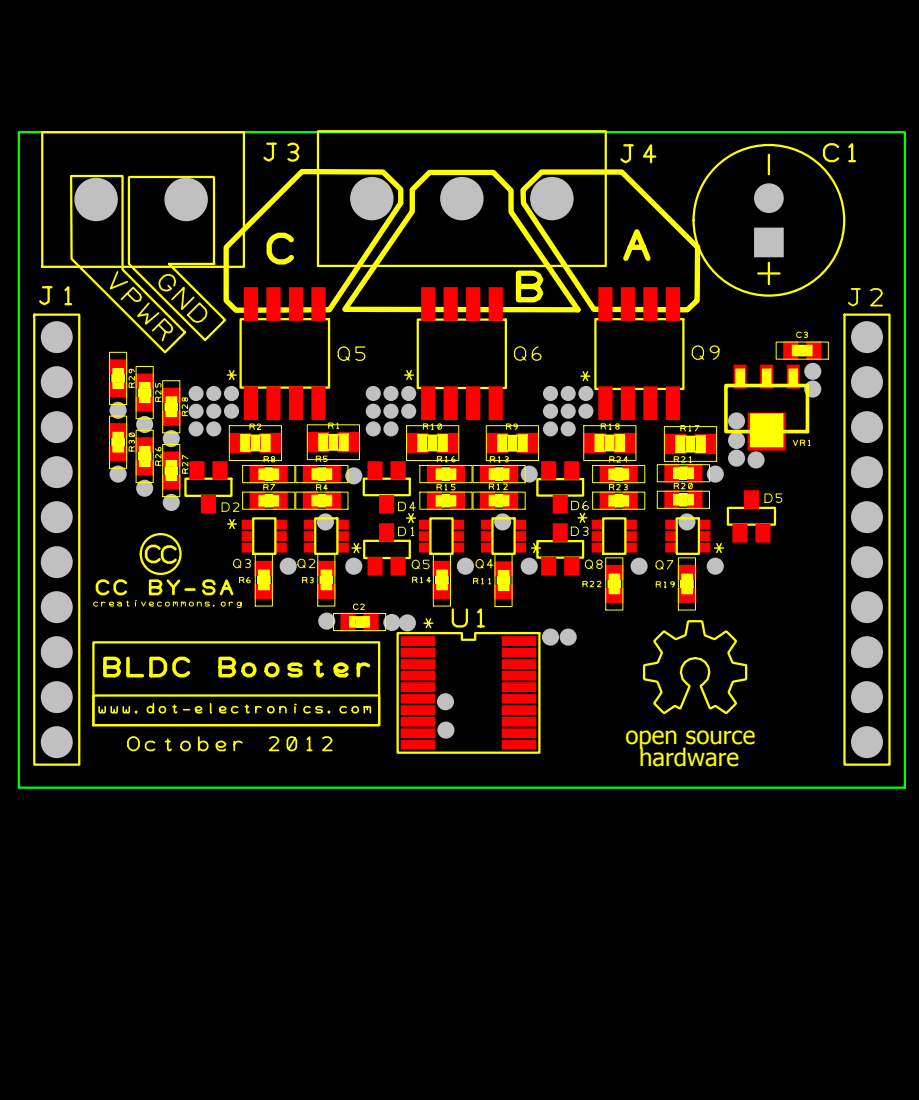
[picture p46: page 1]
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
