lgbeno/BLDC-Booster/hw/pdf/bldc_booster_bottom.PDF

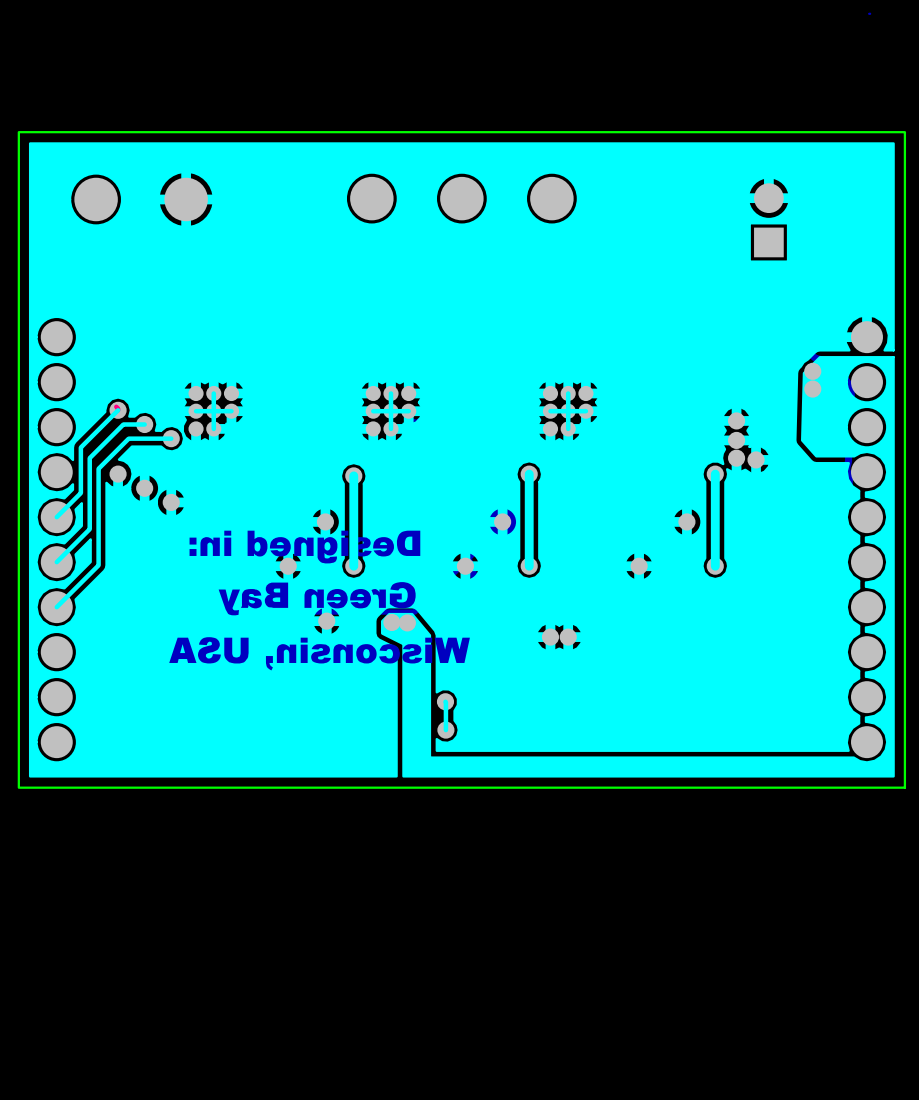
[picture p48: page 1]
