lgbeno/BLDC-Booster/hw/pdf/bldc_booster_sch.pdf

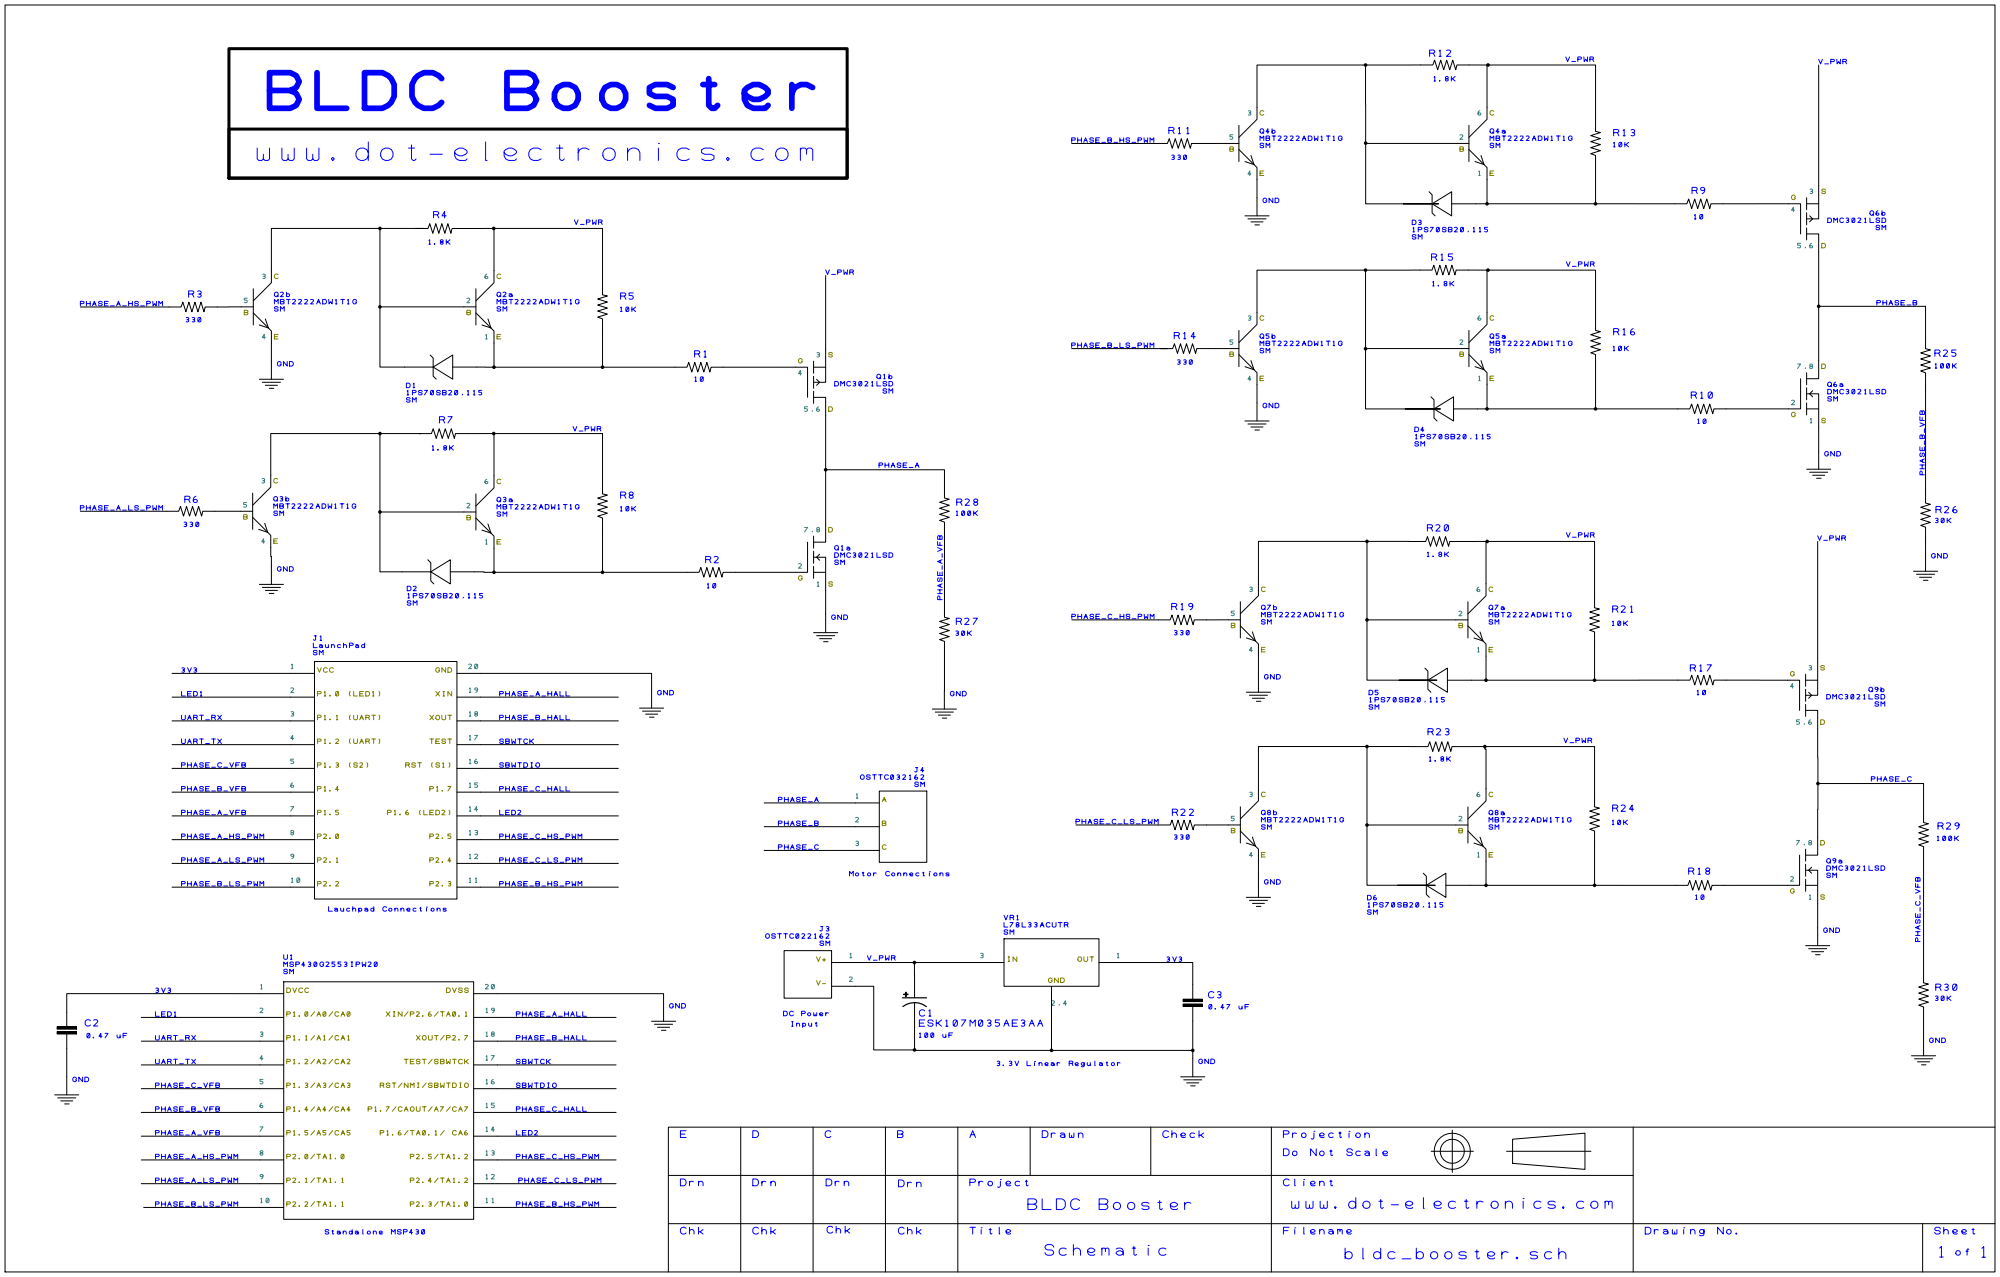
[picture p49: page 1]
