lgbeno/BLDC-Booster/(list of files, drawings)

Other design files:
hw/bldc_booster.pcb
hw/bldc_booster_pro.pcb
hw/bldc_booster_pro_bak2.pcb
hw/bldc_booster_pro_bak.pcb
