lgbeno/BLDC-Booster/(commit log)

2012-09-01 Adding Hardware files to master
    [bldc_booster - Bottom Copper.gbr, bldc_booster - Bottom Documentation.gbr, bldc_booster - Bottom Paste Mask.gbr, bldc_booster - Bottom Silkscreen.gbr, bldc_booster - Bottom Solder Mask.gbr, bldc_booster - Drill Data - Through Hole (Unplated).drl, bldc_booster - Drill Data - Through Hole.drl, bldc_booster - Drill Ident Drawing - Through Hole.gbr]
2012-09-01 Updating logo files for top and bottom silk
    [WI-Icon_sim.dxf, wi_bottom.dxf]
2012-09-01 Changes made to add logos to bottomside silk and updated all drawings
    [bldc_booster - Bottom Copper.gbr, bldc_booster - Bottom Documentation.gbr, bldc_booster - Bottom Silkscreen.gbr, bldc_booster - Bottom Solder Mask.gbr, bldc_booster - Drill Data - Through Hole (Unplated).drl, bldc_booster - Drill Data - Through Hole.drl, bldc_booster - Drill Ident Drawing - Through Hole.gbr, bldc_booster - Top Copper.gbr]
2012-09-01 Added Hall effect state information for reference
2012-09-01 Just figured out that I did all of the layout upside down, flipped everything to align with Launchpad text
    [bldc_booster - Bottom Copper.gbr, bldc_booster - Bottom Documentation.gbr, bldc_booster - Bottom Silkscreen.gbr, bldc_booster - Bottom Solder Mask.gbr, bldc_booster - Drill Data - Through Hole (Unplated).drl, bldc_booster - Drill Data - Through Hole.drl, bldc_booster - Drill Ident Drawing - Through Hole.gbr, bldc_booster - Top Copper.gbr]
2012-09-02 Modified Bottom side artwork
    [bldc_booster.pcb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]
2012-09-04 Update to Bom and adding merged pdf doc
    [bldc_booster_bom.xls]
2012-09-05 Added optional heatsink part number in case it is needed
    [bldc_booster_bom.xls]
2012-09-05 Motor Spinning.
2012-09-05 adding tina spice simulation on npn gate driver
2012-09-06 Added tiny, tiny, tiny stdio library along with simple serial driver to aid in diagnostic console I/O.
2012-09-15 Updated ADC and Timer0 and Timer1 for proper trigging on PWM cycle
2012-09-20 Added #define to switch between sensored and sensorless control. Added P1OUT toggle for ADC sampling and started shifting ADC samples out of the UART.
2012-09-20 updated with uart debug messages and scope traces
2012-09-23 Added python code for parsing scope serial logs along with a variety of datasets collected during debug
    [adc-fixed-buffered.csv, adc-fixed-buffered2.csv, adc-fixed-buffered3.csv, adc-fixed.csv, adc_sample_nomux.csv, bemf-blank0.csv, bemf-blank1.csv, bemf-blank2.csv]
2012-09-23 Debug code added to main project, ADC Mux bug fixed as well.
    [commutate.c, config.h, main.c]
2012-10-03 modified code to run sensorless (poorly) but none the less, the motor is spinning.
2012-10-06 No hall effects! Motor is spinning completely without hall feedback. Seems pretty efficient too.
    [integral-debug.csv]
2012-10-09 These parameters will spin the blue motor.
2012-10-14 Added serial protocol for sending and receiving data via the UART
2012-10-23 Adding images of hardware & python/QT ui.
    [bldc_booster_bom.xls, integral-debug.csv]
2012-10-24 added TH component list
    [bldc_booster_bom.xls]
2012-12-06 Adding PWM VHDL files to repo as well as testbench & tcl scripts
2012-12-06 adding a wave do file for the pwm simulation
2012-12-07 Adding the bldc mux hdl & updated sim to the repo
2012-12-31 adding the debug build folder
    [commutate.obj, getchar.obj, gets.obj, hall.obj, printf.obj, putchar.obj, puts.obj, pwm.obj]
2012-12-31 new v2 pcb data and some hdl enhancements
    [bldc_booster - Bottom Copper.gbr, bldc_booster - Bottom Documentation.gbr, bldc_booster - Bottom Paste Mask.gbr, bldc_booster - Bottom Silkscreen.gbr, bldc_booster - Bottom Solder Mask.gbr, bldc_booster - Drill Data - Through Hole (Unplated).drl, bldc_booster - Drill Data - Through Hole.drl, bldc_booster - Drill Ident Drawing - Through Hole.gbr]
2012-12-31 update to pcb
    [bldc_booster.pcb]
2013-07-10 adding BLDC booster pro design files
    [bldc_booster_pro.pcb, bldc_booster_pro.sch, bldc_booster_pro_bak.pcb, bldc_booster_pro_bak2.pcb]
